Jayweiii/Clockor/renders/base-controller_3d.jpg

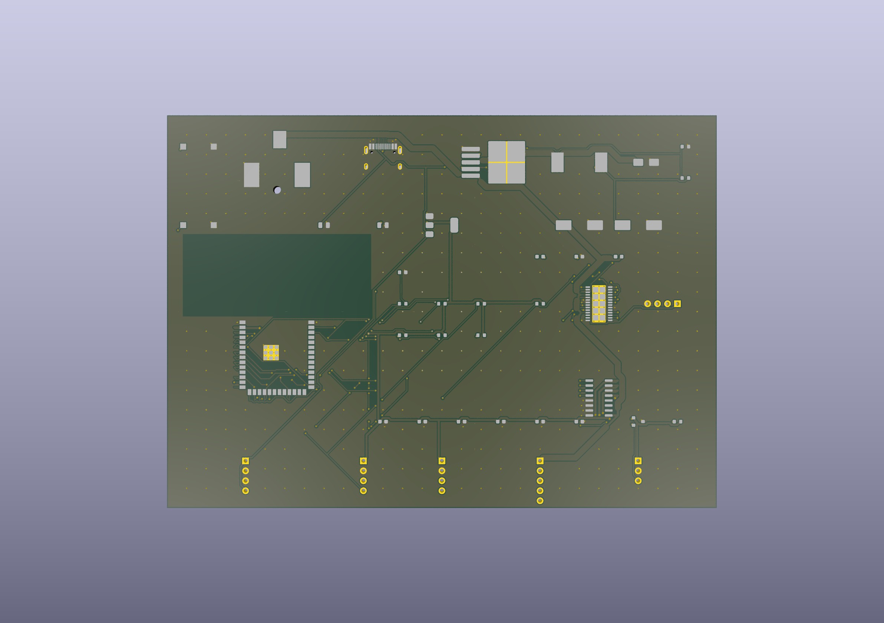
renders/base-controller_3d.jpg
