Jayweiii/Clockor/docs/pcb-status.md

# PCB status — Clockor (updated 2026-11-02, base board routing pass v0.5)

## Update 2026-11-05: `+5V` power-first reroute

`scripts/reroute_net.py` (generated by `scripts/gen_reroute_net.py`) re-routes only a chosen set of nets; all other copper and the pours stay as fixed obstacles. Rip set here: `+5V`, `VIN_12V`, `BUCK_SW`, `USB_D+`, `USB_D-`, `M1_IN1`, `M1_EN1`. `+5V` is routed first. Ripping `+5V` alone (or with `USB_D±`) only gave 0.3 mm, because the fixed `VIN_12V` and `BUCK_SW` copper blocked the trunk. `M1_IN1` / `M1_EN1` were added to keep the U5 GND pocket linked to the pour. The rest of the DRV8313 block is untouched.

DRC (`kicad-cli pcb drc --severity-all --all-track-errors`): **0 violations, 0 unconnected**, one GND cluster. Two `+5V` neck segments at the J2 VBUS pad were shrunk 0.5 -> 0.3 mm (`scripts/fix_clear.py`) to clear `USB_D-` (0.05 mm gap otherwise).

| Net | Min width before / after (mm) | Length < 1.5 mm before / after (mm) | Total after (mm) |
|---|---|---|---|
| `+5V` | 0.25 / 0.25 | 213.0 / 15.1 | 228.8 |
| `VIN_12V` | 0.25 / 0.25 | 24.1 / 23.9 | 170.2 |
| `BUCK_SW` | 0.5 / 0.5 | 0.8 / 0.8 | 28.5 |

`+5V` necks under 1.5 mm total 15.1 mm (target 10 mm): they sit at the fine-pitch pads (J2 VBUS, U3, U2) and at the 0.5 mm stubs of the other pads. `VIN_12V` still has about 24 mm under 1.5 mm; that was out of scope for this pass. `M1_OUTA/B/C`, GND link widths under U5 and the >=4 GND vias near U5 requirement were not touched. KiBot was not run here.

Renders: only the `*_front/back/F_Cu/B_Cu.svg` files were regenerated. The PNG/JPG and 3D renders still show the previous board because `rsvg-convert` was not permitted in this job.

---

## Base board (`base-controller`) — PARTIAL, not yet 0 unconnected

Produced by `scripts/route_base.py` (grid router, rebuilt in this pass; re-runnable: it strips tracks/vias/zones and re-routes). Schematic, footprints, outline and the minute board are untouched.

| Metric (`kicad-cli pcb drc`, repo rules) | Before (main) | After |
|---|---|---|
| Clearance / short errors | 0 | **0** |
| Unconnected items | 68 | **2** (both GND pour clusters) |
| Warnings | 9 (`track_dangling`, `hole_to_hole`) | 0 |

Second pass (`route_base.py` now has rip-up-and-reroute, a via-in-stub escape for the J2 `USB_D+` pads, and a GND cluster check): `M1_CPH`, `M1_OUTC` and `USB_D+` are now routed, and every signal and power net is connected.

**Still unconnected (the blocker):** two small GND pour clusters (DRC reports them as "Zone [GND] on F.Cu" pairs). They are the GND tie vias of the DRV8313 (U5 pins 6/7/9 area, about x 105-107, y 44-50) and of J3 (about x 112, y 43-48). They are boxed in by the M1_OUTA/B/C escapes and the IN1/IN3/CPL lines on B.Cu. The automatic link step ripped nearby nets to route a GND track out, but `M1_CPH` and `M1_OUTC` could not be rerouted afterwards, so it rolled back. This needs a manual fan-out in pcbnew (or moving the DRV8313 support passives).

**Rules applied:** `VIN_12V` and `BUCK_SW` trunks at 1.5 mm (0.5 mm necks at fine-pitch pins); `+3V3` and `HR_OUT*` 0.5 mm; signals 0.25 mm (0.2 mm necks at fine pitch); GND pours on F.Cu and B.Cu with about 5 mm stitching vias; I2C kept clear of the motor phases (5 mm keep-out in the router).

**Tradeoffs / deviations:**
- **`+5V` (XL4015 output) is 0.3 mm, not >=1.5 mm.** Rip-up could not widen it: every attempt boxed in `USB_D-`.
- **`M1_OUTA` / `M1_OUTB` are 0.3 mm, not 1.5-2 mm.** Widening either one failed because it ripped `VIN_12V` (fell to 0.3 mm), `M1_CPH` or `M1_OUTC`. `M1_OUTC` is now 1.5 mm trunk (0.25-0.5 mm at the DRV8313 pin; the pin pitch of 0.65 mm does not allow 1.0 mm there). No >=1.0 mm necks exist at U5 for any phase.
- `M1_V3P3` is 0.25-0.3 mm (requested 0.5 mm).
- Fine-pitch pins use short exact-geometry escape stubs; `M1_EN1` pins on U5 use stub vias and join on B.Cu.
- The U1 antenna keep-out is honoured (no copper or pour under it).

**CI:** `kibot.base.yml` (strict, `ignore_unconnected: false`) is added and picked up for base-controller by the workflow. It stays **red** until the two GND clusters above are closed. KiBot was not run in this job (DRC only). `hand-minute` is unchanged on `kibot.yml`.

Renders: `renders/base-controller_{front,back,3d}.{png,jpg}` and `_F_Cu.svg` / `_B_Cu.svg` front/back PNG+JPG and the F_Cu/B_Cu SVGs are regenerated; the 3D view was not regenerated (kicad-cli rejected the rotate option in this job). Previous versions are in `renders/before/`.

---

## Previous status (2026-11-01)

## Goal
Finish routing both boards without shorts, clear silk/courtyard/hole/dangling-via **errors**, target **0 non-unconnected DRC errors**, then enable DRC in KiBot CI (`ignore_unconnected: true` until UC=0).

## Result (honest)

| Board | ERC errors | ERC warnings | DRC shorts | Non-UC DRC **errors** | Unconnected | DRC warnings |
|---|---|---|---|---|---|---|
| `base-controller` | **0** | ~217 (`lib_symbol_issues`, `endpoint_off_grid`, …) | **0** | **0** | **68** | ~9 (`hole_to_hole`, `via_dangling`) |
| `hand-minute` | **0** | ~406 (same classes) | **0** | **0** | **74** | ~2 (`hole_to_hole`, `via_dangling`) |

**Shorts: 0.** **Non-unconnected DRC errors: 0** on both boards (clearance / hole_clearance / copper_edge / copper_sliver / track_dangling cleaned).

**Full 0-unconnected not reached** with the pattern/MST/via router on these dense hub layouts. Remaining UC nets need manual pcbnew work or a better autorouter. **CI `run_drc: true`** with `ignore_unconnected: true` (and existing `unconnected_items` filter) so the pipeline enforces zero real DRC errors without failing on unfinished nets.

Local reports: `review/*_drc.rpt`, `review/*_erc.rpt`.  
Review renders: `renders/*_{F_Cu,B_Cu,front,back,3d}.{png,jpg}` plus `.step` / `.glb`.

## How routed / cleaned
- `scripts/place_and_route.py` — placements + rules; GND pour **B.Cu only**.
- `scripts/finish_route.py` — pad/keepout obstacles, LED spines, MST, via patterns; short-clean.
- `scripts/second_pass.py` — DRC-pair reconnect (diminishing returns ~65–74 UC).
- Hygiene: strip F/B.CrtYd + dense silk; NPTH copper purge (J2 barrel); dangling track/via delete; hole_clearance 0; copper_edge 0.05 mm.

## Schematic Round 3 (base) — unchanged
- U6 `AH1806-W-7` hour-home hall + R22 10k + J9 → `/HR_HOME` (GPIO19).
- Hour drive **1:1** front-of-sweep stub axle (no hollow tube).

## Remaining PCB work
1. Manually finish ~68 / ~74 unconnected nets (or upgrade router).
2. Clear remaining `hole_to_hole` / `via_dangling` **warnings**.
3. Flip `ignore_unconnected` to false only when UC = 0.
