Jayweiii/Clockor/renders/base-controller_back.jpg

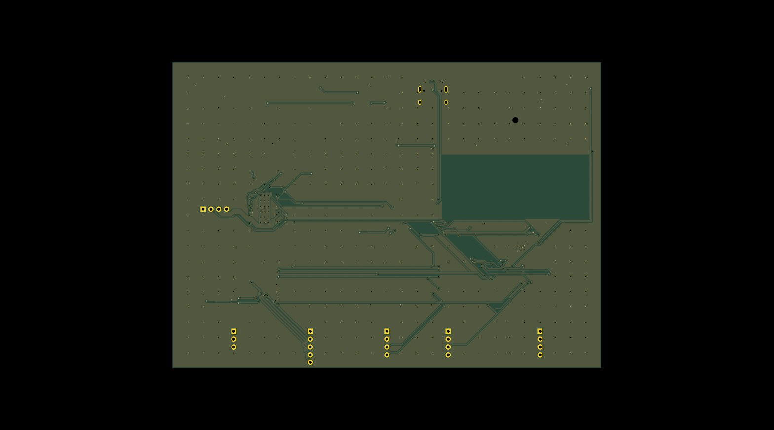
renders/base-controller_back.jpg
