Jayweiii/Clockor/renders/base-controller_back.png

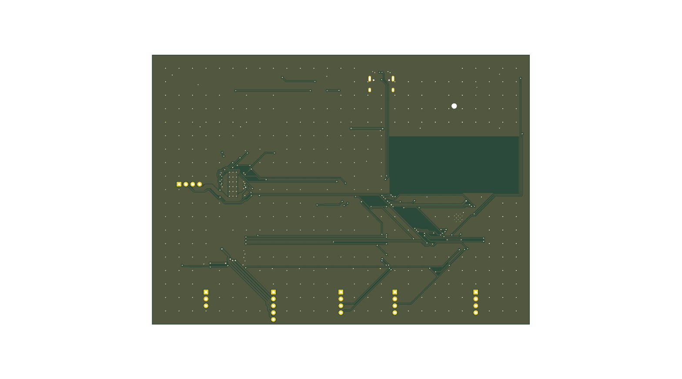
renders/base-controller_back.png
