Jayweiii/Clockor/renders/base-controller_front.jpg

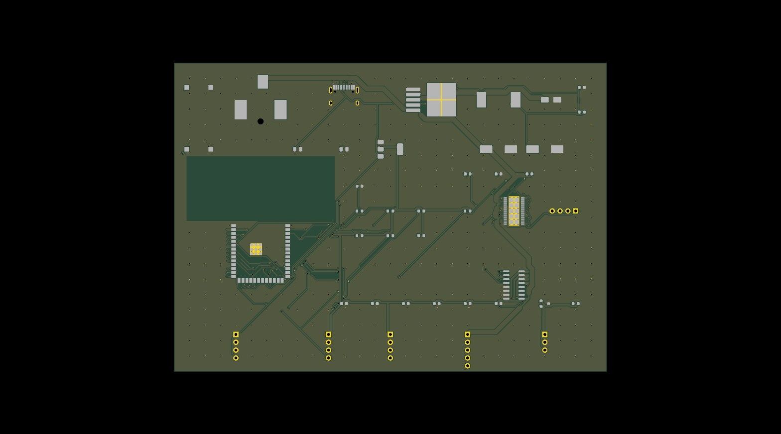
renders/base-controller_front.jpg
