Jayweiii/Clockor/renders/base-controller_front.png

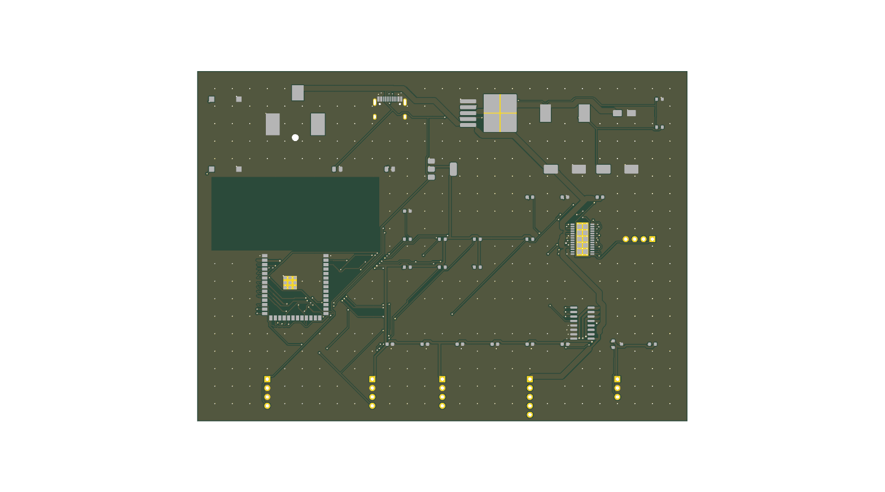
renders/base-controller_front.png
