Jayweiii/Clockor/renders/before/base-controller_3d.png

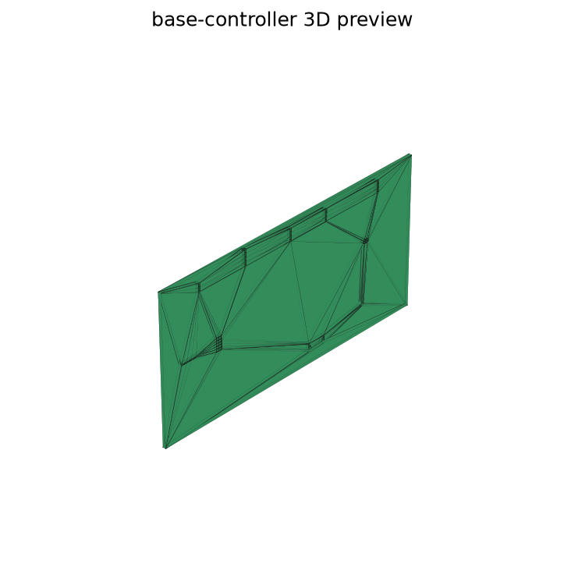
renders/before/base-controller_3d.png
