Jayweiii/Clockor/renders/before/base-controller_B_Cu.png

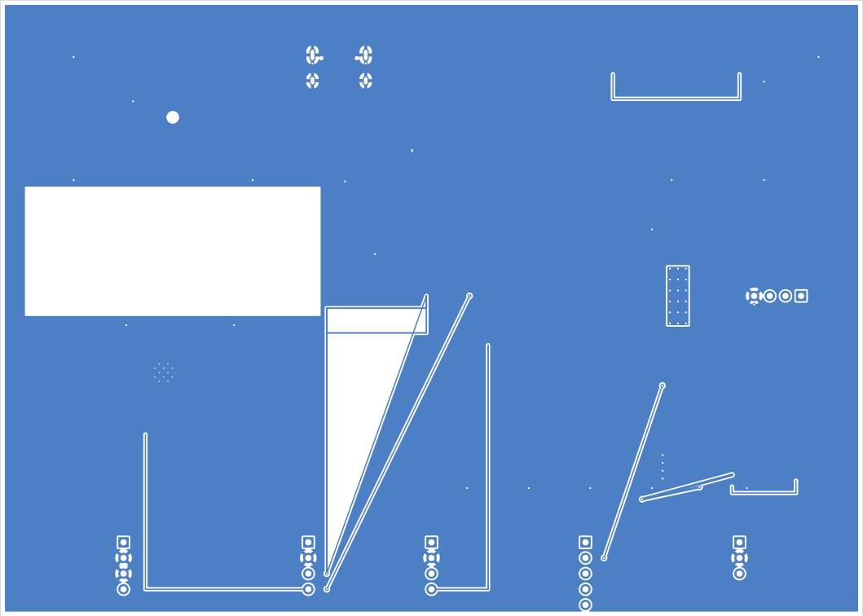
renders/before/base-controller_B_Cu.png
