Jayweiii/Clockor/renders/before/base-controller_F_Cu.png

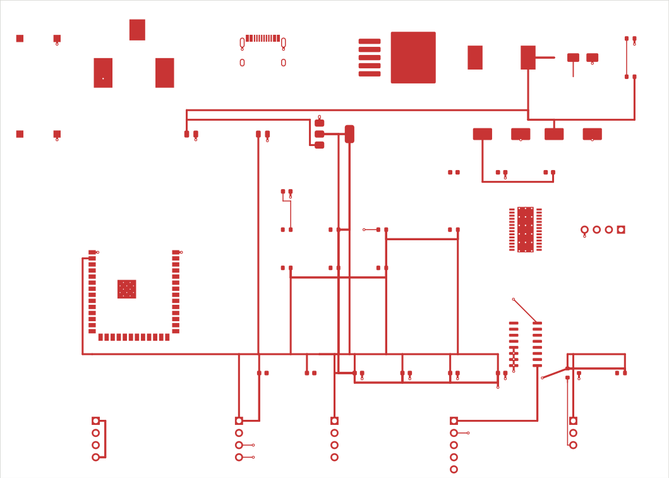
renders/before/base-controller_F_Cu.png
