Jayweiii/Clockor/renders/hand-minute_3d.jpg

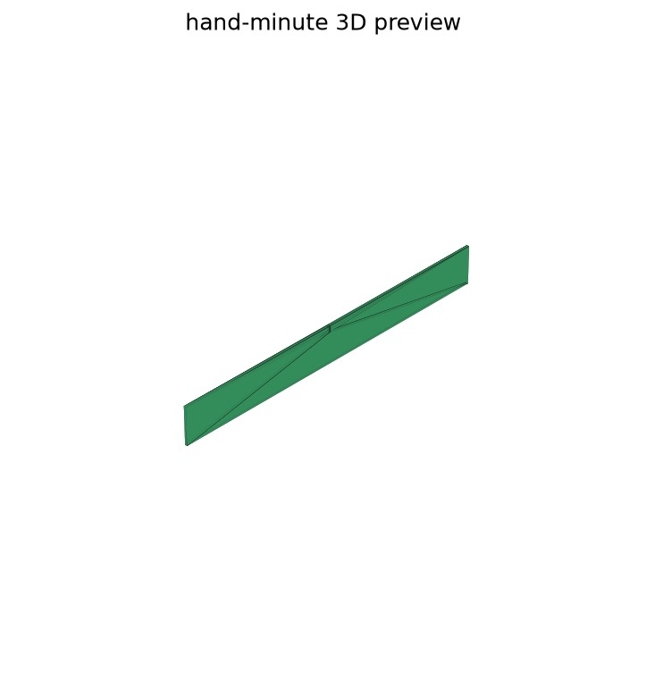
renders/hand-minute_3d.jpg
