Jayweiii/Clockor/renders/hand-minute_B_Cu.jpg

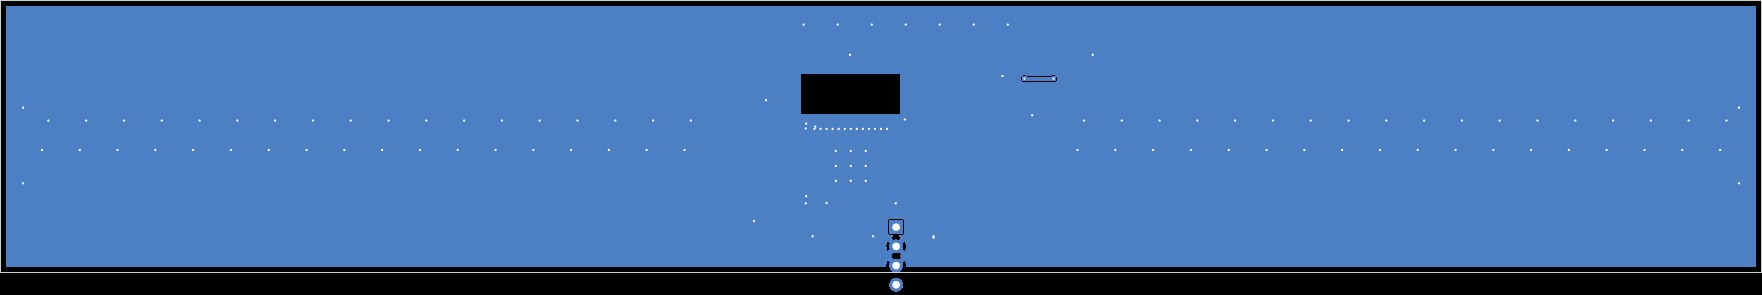
renders/hand-minute_B_Cu.jpg
