Jayweiii/Clockor/renders/hand-minute_B_Cu.png

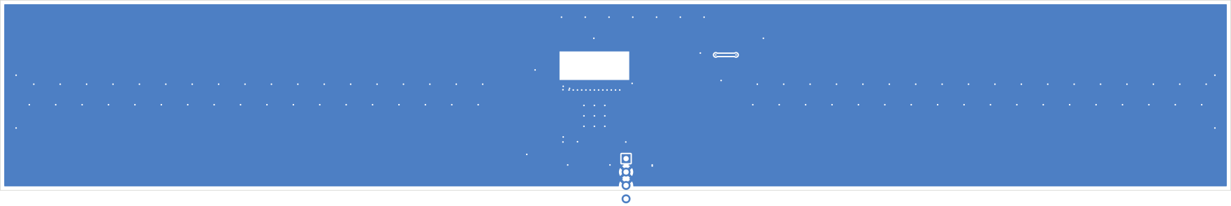
renders/hand-minute_B_Cu.png
