Jayweiii/Clockor/renders/hand-minute_F_Cu.jpg

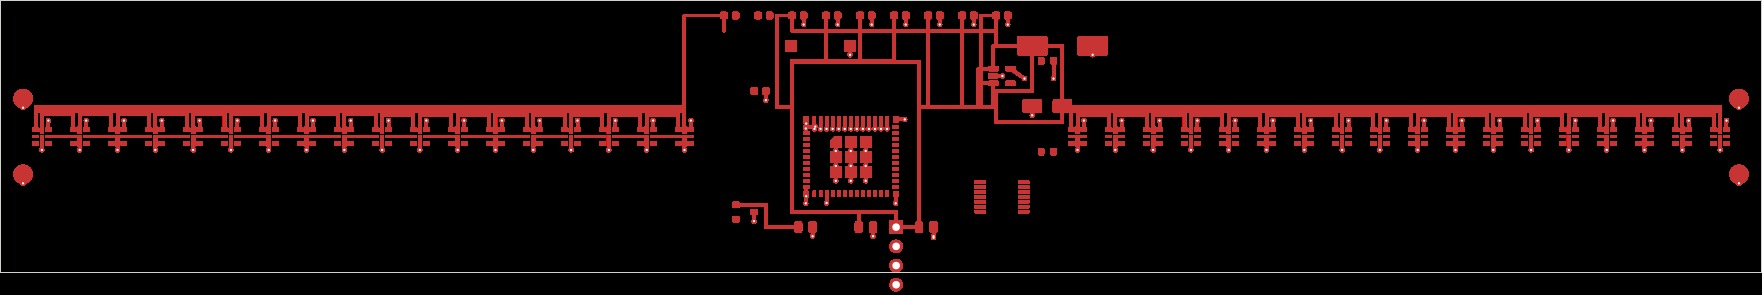
renders/hand-minute_F_Cu.jpg
