Jayweiii/Clockor/renders/hand-minute_F_Cu.png

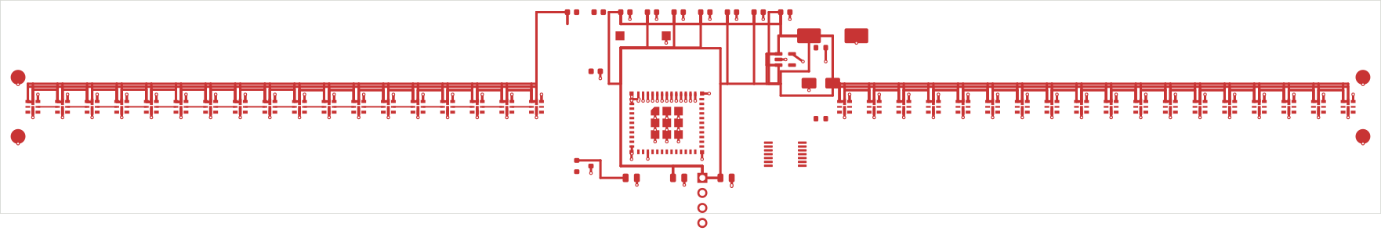
renders/hand-minute_F_Cu.png
