Jayweiii/Clockor/bom/master_bom_aggregated.csv

Value | Footprint | LCSC | Qty | Refs
100nF | Capacitor_SMD:C_0603_1608Metric |  | 17 | base-controller:C10;base-controller:C11;base-controller:C12;base-controller:C13;base-controller:C14;base-controller:C15;base-controller:C21;hand-minute:C1;hand-minute:Cd1;hand-minute:Cd2;hand-minute:Cd3;hand-minute:Cd4;hand-minute:Cd5;hand-minute:Cd6;hand-minute:Cd7;hand-minute:Cd8;hand-minute:Cd9
10k | Resistor_SMD:R_0603_1608Metric |  | 4 | base-controller:R20;base-controller:R21;hand-minute:R1;hand-minute:R2
10nF | Capacitor_SMD:C_0603_1608Metric |  | 1 | base-controller:C20
10uF | Capacitor_SMD:C_0805_2012Metric |  | 2 | base-controller:C4;hand-minute:C4
1k | Resistor_SMD:R_0603_1608Metric |  | 2 | base-controller:R1;base-controller:R4
22uF | Capacitor_SMD:C_0805_2012Metric |  | 3 | base-controller:C3;hand-minute:C2;hand-minute:C3
3.00k | Resistor_SMD:R_0603_1608Metric |  | 1 | base-controller:R5
4.7k | Resistor_SMD:R_0603_1608Metric |  | 4 | base-controller:R2;base-controller:R3;base-controller:R6;base-controller:R7
470nF | Capacitor_SMD:C_0603_1608Metric |  | 1 | base-controller:C22
470uF | Capacitor_SMD:CP_Elec_10x10 |  | 3 | base-controller:C1;base-controller:C2;hand-minute:C5
47uH | Inductor_SMD:L_TaiTech_TMPC1265_13.5x12.5mm |  | 1 | base-controller:L1
AH1806-W-7 | Package_TO_SOT_SMD:SC-59 | C126663 | 1 | hand-minute:U4
AMS1117-3.3 | Package_TO_SOT_SMD:SOT-223-3_TabPin2 | C6186 | 1 | base-controller:U3
APA102-2020 | LED_SMD:LED-APA102-2020 | C22439302 | 36 | hand-minute:D1;hand-minute:D2;hand-minute:D3;hand-minute:D4;hand-minute:D5;hand-minute:D6;hand-minute:D7;hand-minute:D8;hand-minute:D9;hand-minute:D10;hand-minute:D11;hand-minute:D12;hand-minute:D13;hand-minute:D14;hand-minute:D15;hand-minute:D16;hand-minute:D17;hand-minute:D18;hand-minute:D19;hand-minute:D20;hand-minute:D21;hand-minute:D22;hand-minute:D23;hand-minute:D24;hand-minute:D25;hand-minute:D26;hand-minute:D27;hand-minute:D28;hand-minute:D29;hand-minute:D30;hand-minute:D31;hand-minute:D32;hand-minute:D33;hand-minute:D34;hand-minute:D35;hand-minute:D36
BAL_PAD | TestPoint:TestPoint_Pad_D2.5mm |  | 4 | hand-minute:TP1;hand-minute:TP2;hand-minute:TP3;hand-minute:TP4
BOOT | Button_Switch_SMD:SW_SPST_CK_RS282G05A3 |  | 2 | base-controller:SW1;hand-minute:SW1
Conn_01x04 | Connector_PinHeader_2.54mm:PinHeader_1x04_P2.54mm_Vertical |  | 4 | base-controller:J3;base-controller:J5;base-controller:J6;base-controller:J7
Conn_01x05 | Connector_PinHeader_2.54mm:PinHeader_1x05_P2.54mm_Vertical |  | 1 | base-controller:J8
DC005-2.5 | Connector_BarrelJack:BarrelJack_CUI_PJ-036AH-SMT_Horizontal |  | 1 | base-controller:J1
DRV8313PWPR | Package_SO:HTSSOP-28-1EP_4.4x9.7mm_P0.65mm_EP3.4x9.5mm_ThermalVias | C92482 | 1 | base-controller:U5
ESP32-C3-MINI-1-N4 | Espressif:ESP32-C3-MINI-1 | C2934560 | 1 | hand-minute:U1
ESP32-S3-WROOM-1-N16R8 | RF_Module:ESP32-S3-WROOM-1 | C2913202 | 1 | base-controller:U1
LED_R | LED_SMD:LED_0603_1608Metric |  | 1 | base-controller:D2
ME6211C33M5G-N | Package_TO_SOT_SMD:SOT-23-5 | C235316 | 1 | hand-minute:U2
MODE | Button_Switch_SMD:SW_SPST_CK_RS282G05A3 |  | 1 | base-controller:SW2
SLIP_5V | Connector_PinHeader_2.54mm:PinHeader_1x04_P2.54mm_Vertical |  | 1 | hand-minute:J1
SMAJ5.0A | Diode_SMD:D_SMA | C83329 | 1 | hand-minute:D40
SN74AHCT125PWR | Package_SO:TSSOP-14_4.4x5mm_P0.65mm | C5947 | 1 | hand-minute:U3
SS54 | Diode_SMD:D_SMA | C8678 | 1 | base-controller:D1
TYPE-C-31-M-12 | Connector_USB:USB_C_Receptacle_HRO_TYPE-C-31-M-12 |  | 1 | base-controller:J2
ULN2003ADR | Package_SO:SOIC-16_3.9x9.9mm_P1.27mm | C7512 | 1 | base-controller:U4
XL4015E1 | Package_TO_SOT_SMD:TO-263-5_TabPin3 | C51661 | 1 | base-controller:U2
Furitek KOMODO 2204 1400KV | Minute BLDC 12S14P | 1 | mech | https://furitek.com/products/furitek-2204-outrunner-1400kv-motor
Mercotac 205 | Slip ring 2x4A 2000RPM | 1 | mech | https://www.mercotac.com/html/205.html
28BYJ-48 5V | Hour stepper off-axis | 1 | mech | common
Clear acrylic dial | Diffuser/face >=5mm gap | 1 | mech | local
