Jayweiii/Clockor/cad/pov_clock_assembly.step

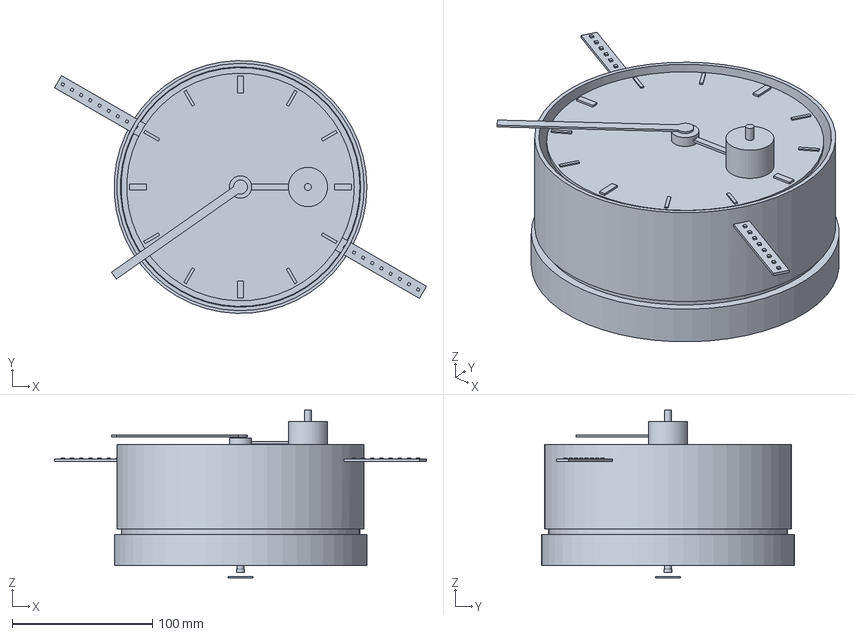
[picture p14: CAD file, 2026-11-01]
cad/pov_clock_assembly.step
264.8 x 179.9 x 119.5 mm
