Jayweiii/Clockor/cad/pov_clock_pov_mode.stl

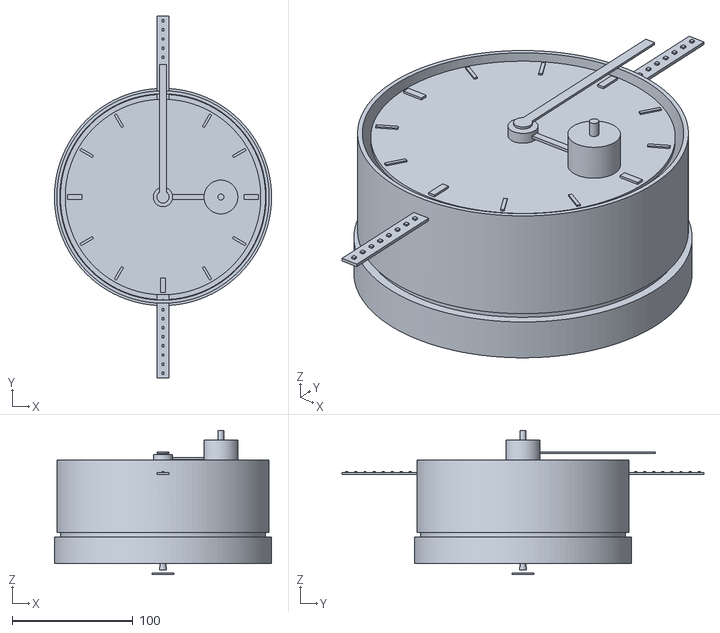
[picture p15: CAD file, 2026-11-01]
cad/pov_clock_pov_mode.stl
180.0 x 300.0 x 119.5
