Jayweiii/Clockor/renders/base-controller.step

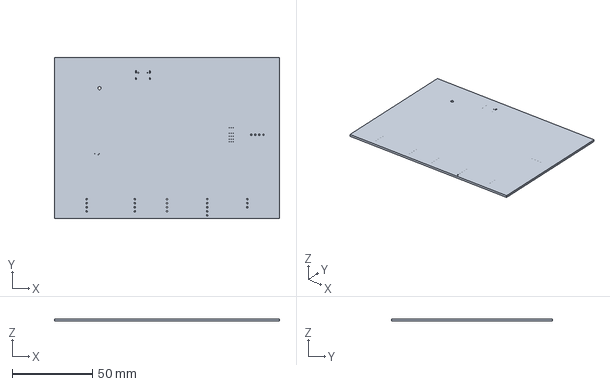
[picture p16: CAD file, 2026-11-01]
renders/base-controller.step
140.0 x 100.0 x 1.51 mm
