Jayweiii/Clockor/renders/hand-minute.step

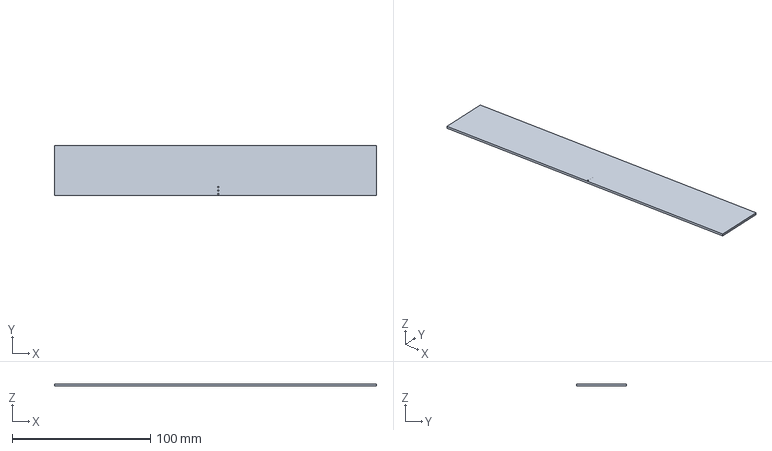
[picture p17: CAD file, 2026-11-01]
renders/hand-minute.step
233.0 x 36.0 x 1.51 mm
