Jayweiii/Clockor/cad/pov_clock_section.stl

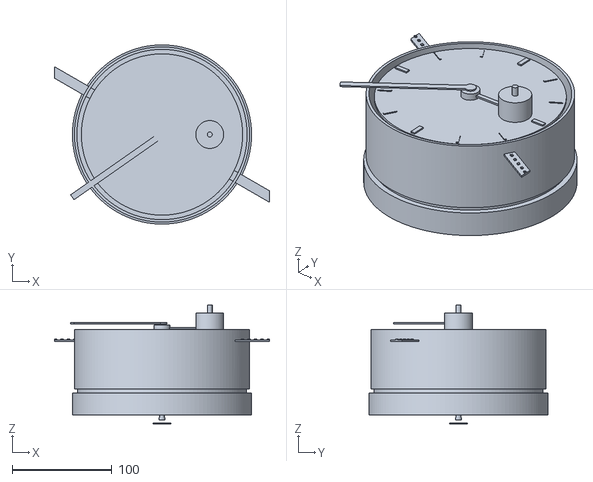
[picture p18: CAD file, 2026-11-01]
cad/pov_clock_section.stl
216.0 x 179.9 x 119.5
