Jayweiii/Clockor/cad/pov_clock_exploded.stl

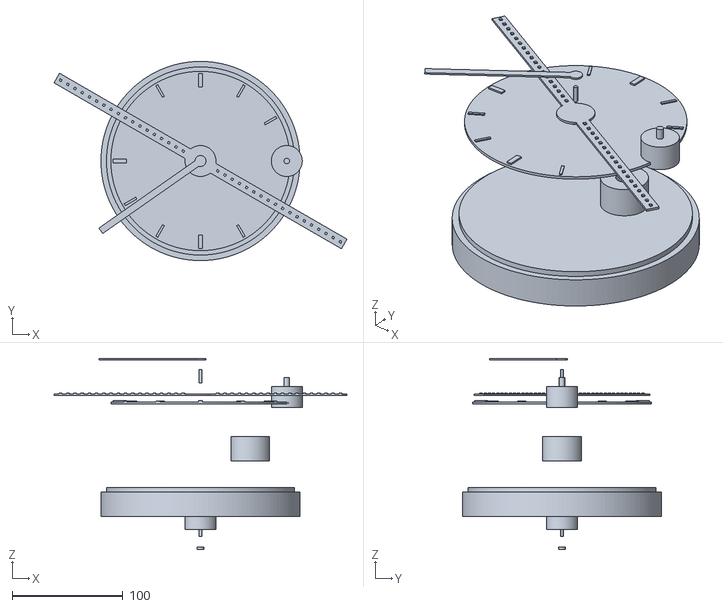
[picture p19: CAD file, 2026-11-01]
cad/pov_clock_exploded.stl
264.8 x 179.9 x 172.7
