Jayweiii/Clockor/(list of files, cad)

Other CAD files:
cad/pov_clock_clock_mode.stl
cad/pov_clock_assembly.stl
