Jayweiii/Clockor/review/hand-minute_schematic.pdf

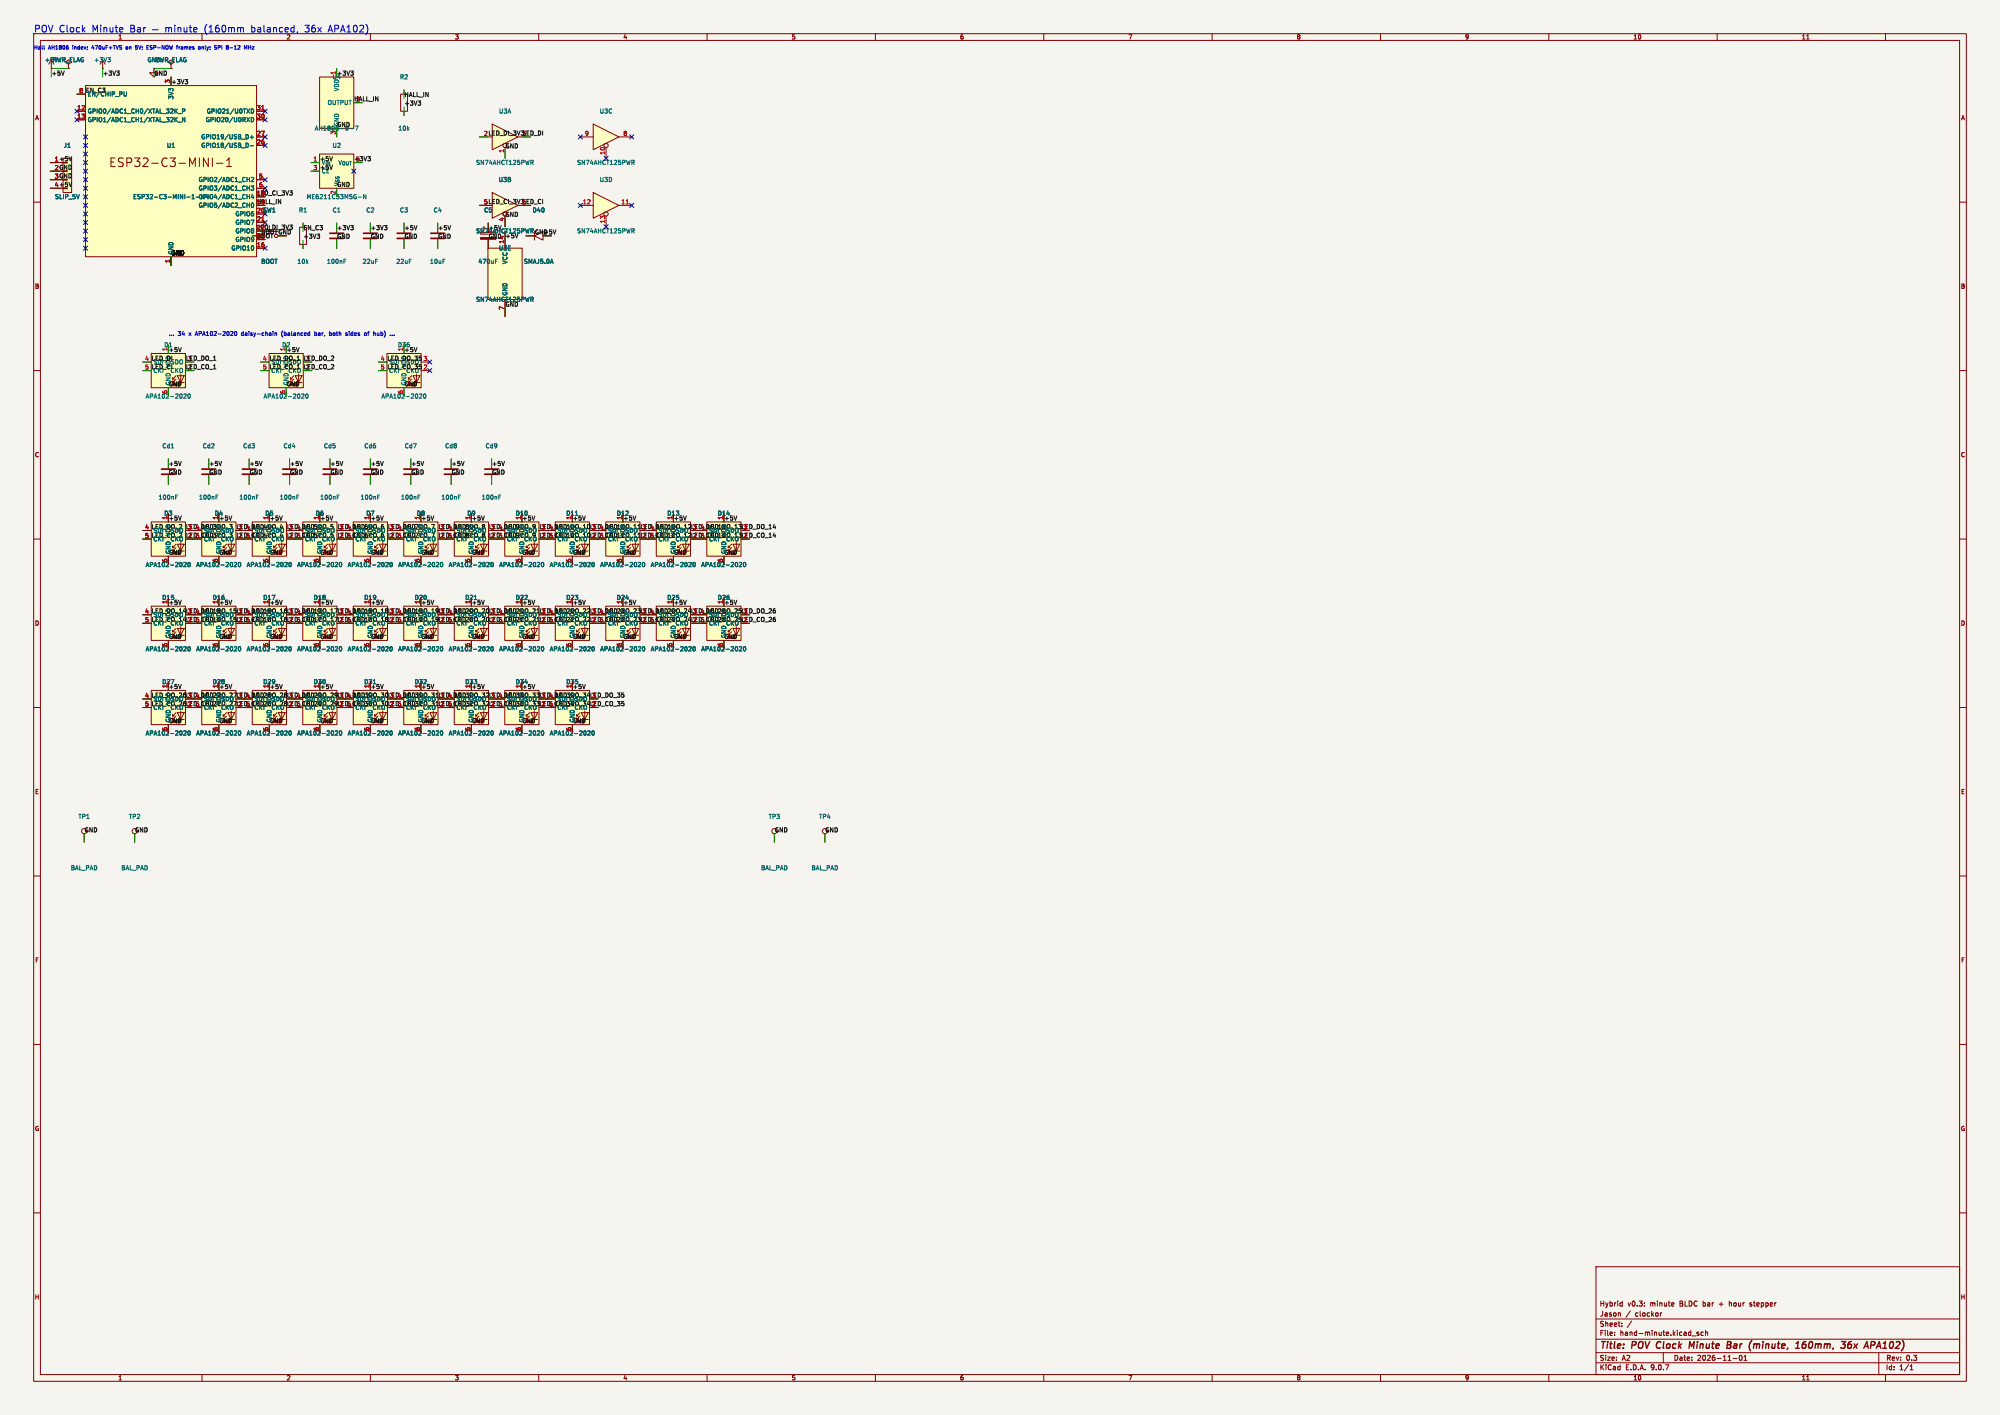
[picture p20: page 1]

6 SDO 3 CKO 2 D3 APA102-2020 SDI 4 CKI 5 VDD

6 SDO 3 CKO 2 D4 APA102-2020 SDI 4 CKI 5 VDD
LED_DO_16 +5V

6 SDO 3 CKO 2 D6 APA102-2020 SDI 4 CKI 5 VDD

6 SDO 3 CKO 2 D5 APA102-2020 SDI 4 CKI 5 VDD

6 SDO 3 CKO 2 D7 APA102-2020 SDI 4 CKI 5 VDD
LED_DO_6 +5V

6 SDO 3 CKO 2 D8 APA102-2020 SDI 4 CKI 5 VDD

6 SDO 3 CKO 2 D9 APA102-2020 SDI 4 CKI 5 VDD

6 SDO 3 CKO 2 D10 APA102-2020 SDI 4 CKI 5 VDD

6 SDO 3 CKO 2 D11 APA102-2020 SDI 4 CKI 5 VDD

6 SDO 3 CKO 2 D12 APA102-2020 SDI 4 CKI 5 VDD

6 SDO 3 CKO 2 D13 APA102-2020 SDI 4 CKI 5 VDD

6 SDO 3 CKO 2 D17 APA102-2020 SDI 4 CKI 5 VDD

6 SDO 3 CKO 2 D16 APA102-2020 SDI 4 CKI 5 VDD

6 SDO 3 CKO 2 D20 APA102-2020 SDI 4 CKI 5 VDD

6 SDO 3 CKO 2 D21 APA102-2020 SDI 4 CKI 5 VDD

6 SDO 3 CKO 2 D26 APA102-2020 SDI 4 CKI 5 VDD

6 SDO 3 CKO 2 D15 APA102-2020 SDI 4 CKI 5 VDD

6 SDO 3 CKO 2 D18 APA102-2020 SDI 4 CKI 5 VDD

6 SDO 3 CKO 2 D19 APA102-2020 SDI 4 CKI 5 VDD

6 SDO 3 CKO 2 D22 APA102-2020 SDI 4 CKI 5 VDD
LED_DO_21 +5V

6 SDO 3 CKO 2 D25 APA102-2020 SDI 4 CKI 5 VDD

6 SDO 3 CKO 2 D24 APA102-2020 SDI 4 CKI 5 VDD

6 SDO 3 CKO 2 D23 APA102-2020 SDI 4 CKI 5 VDD

6 SDO 3 CKO 2 D29 APA102-2020 SDI 4 CKI 5 VDD

6 SDO 3 CKO 2 D35 APA102-2020 SDI 4 CKI 5 VDD
LED_CO_22

6 SDO 3 CKO 2 D28 APA102-2020 SDI 4 CKI 5 VDD

6 SDO 3 CKO 2 D30 APA102-2020 SDI 4 CKI 5 VDD

6 SDO 3 CKO 2 D31 APA102-2020 SDI 4 CKI 5 VDD

6 SDO 3 CKO 2 D33 APA102-2020 SDI 4 CKI 5 VDD
LED_DO_32 GND
LED_CO_32

6 SDO 3 CKO 2 D34 APA102-2020 SDI 4 CKI 5 VDD
LED_DO_33 GND
LED_CO_33
