Jayweiii/Clockor/hardware/base-controller/base-controller.kicad_pcb

## KiCad design hardware/base-controller/base-controller.kicad_pcb (2026-11-05)

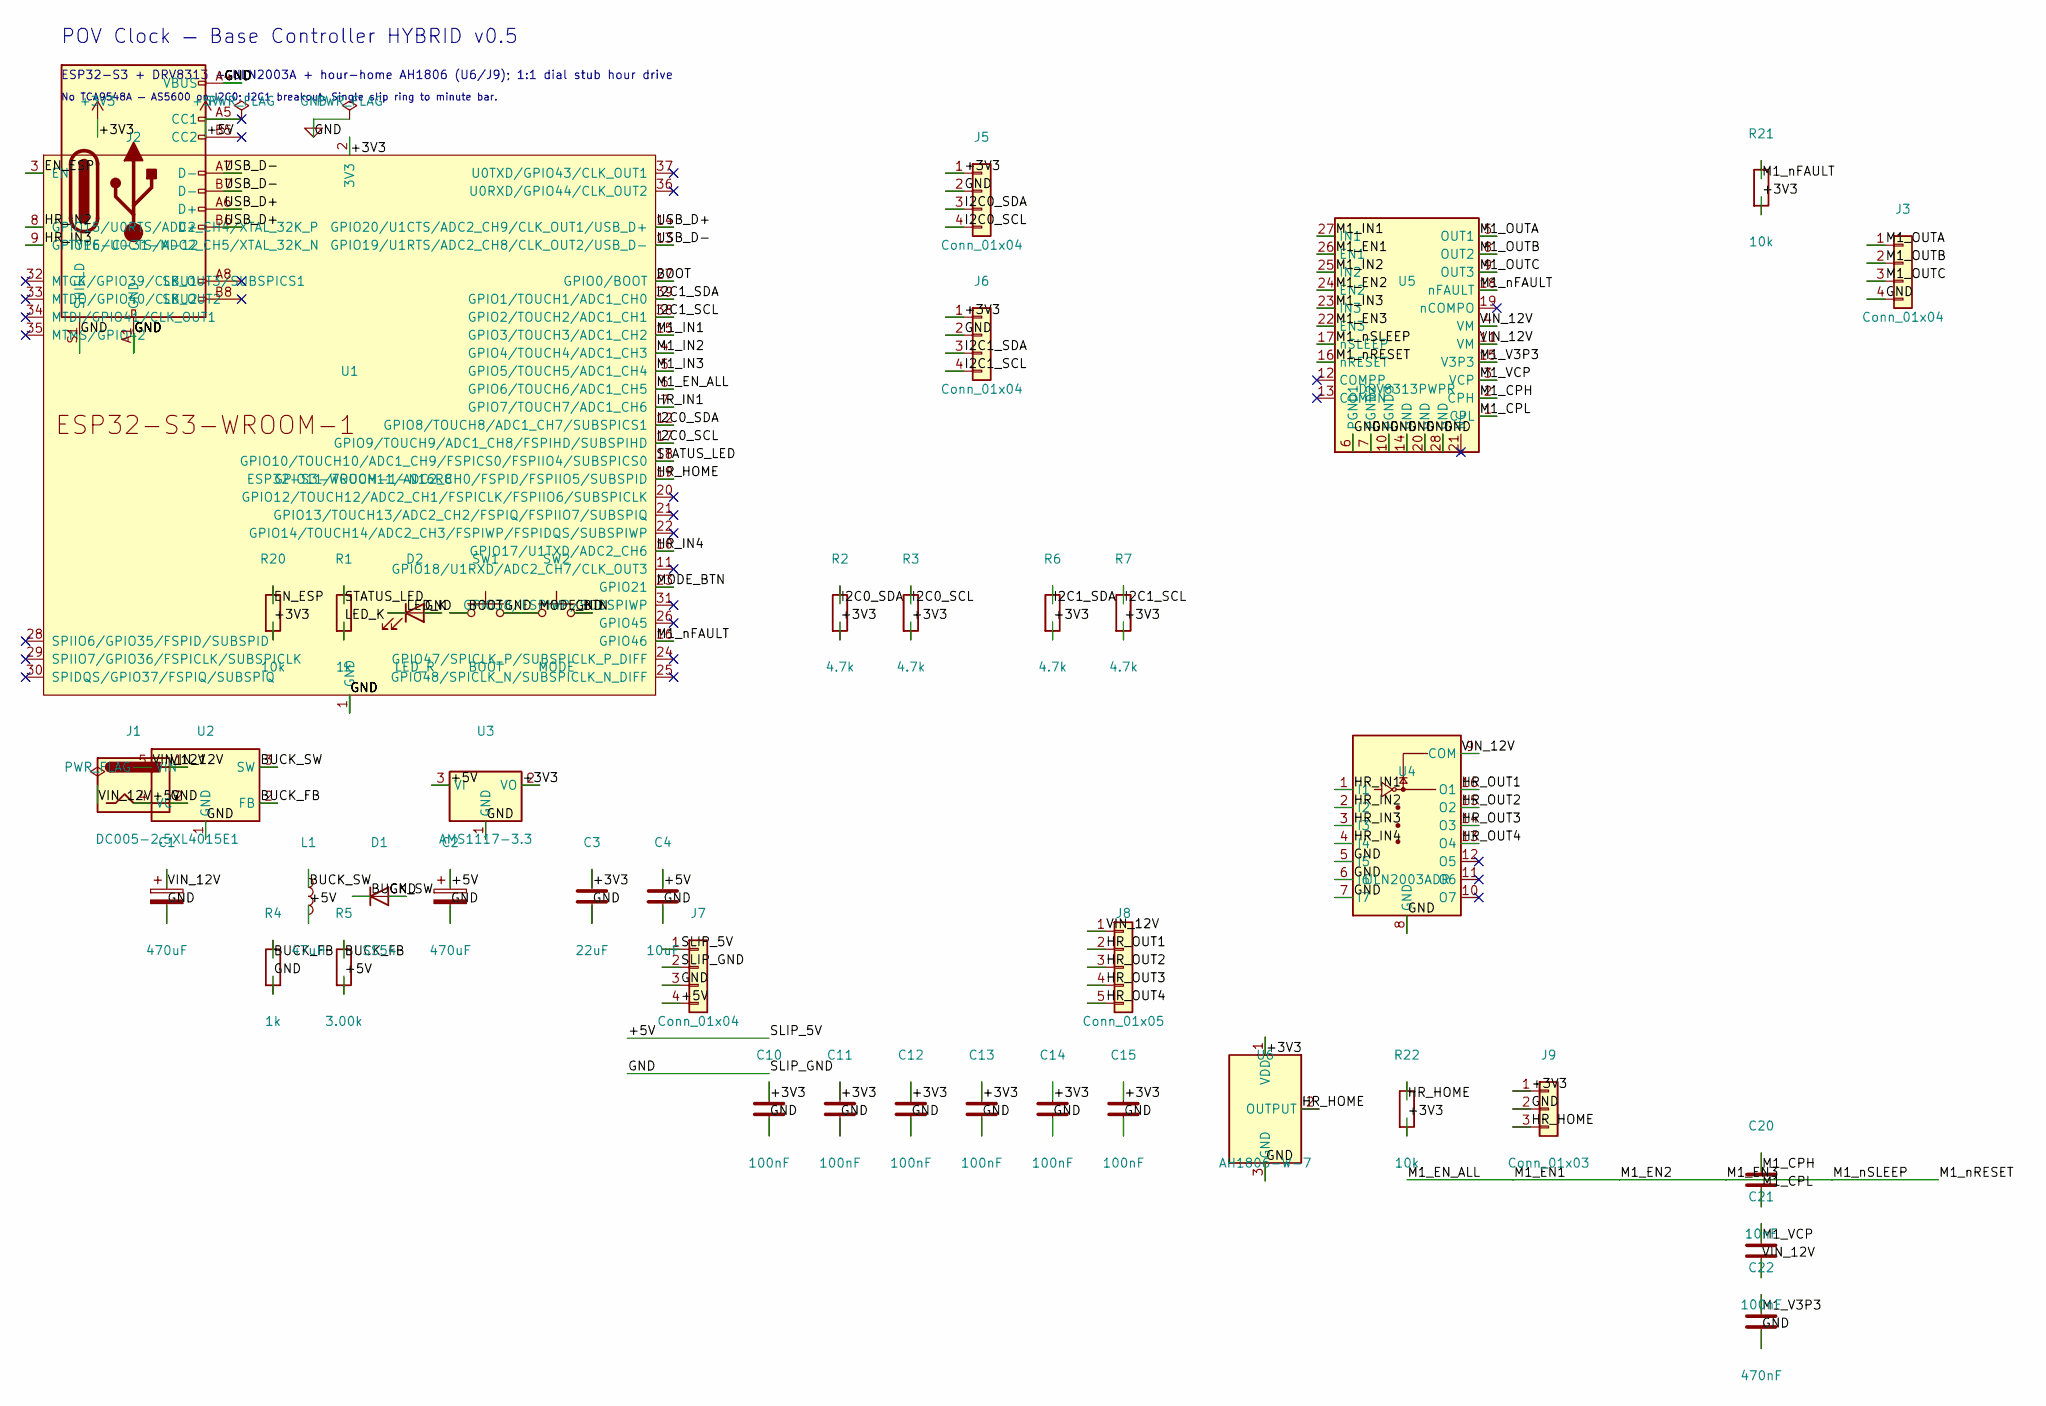
[picture p22: schematic base-controller.kicad_sch, POV Clock — Base Controller (Hybrid)]

Parts:
C1, C2: 470uF; CP_Elec_10x10
C3: 22uF; C_0805_2012Metric
C4: 10uF; C_0805_2012Metric
C10, C11, C12, C13, C14, C15, C21: 100nF; C_0603_1608Metric
C20: 10nF; C_0603_1608Metric
C22: 470nF; C_0603_1608Metric
D1: SS54; D_SMA
D2: LED_R; LED_0603_1608Metric
J1: DC005-2.5; BarrelJack_CUI_PJ-036AH-SMT_Horizontal
J2: TYPE-C-31-M-12; USB_C_Receptacle_HRO_TYPE-C-31-M-12
J3, J5, J6, J7: Conn_01x04; PinHeader_1x04_P2.54mm_Vertical
J8: Conn_01x05; PinHeader_1x05_P2.54mm_Vertical
J9: Conn_01x03; PinHeader_1x03_P2.54mm_Vertical
L1: 47uH; L_TaiTech_TMPC1265_13.5x12.5mm
R1, R4: 1k; R_0603_1608Metric
R2, R3, R6, R7: 4.7k; R_0603_1608Metric
R5: 3.00k; R_0603_1608Metric
R20, R21, R22: 10k; R_0603_1608Metric
SW1: BOOT; SW_SPST_CK_RS282G05A3
SW2: MODE; SW_SPST_CK_RS282G05A3
U1: ESP32-S3-WROOM-1-N16R8; ESP32-S3-WROOM-1
U2: XL4015E1; TO-263-5_TabPin3
U3: AMS1117-3.3; SOT-223-3_TabPin2
U4: ULN2003ADR; SOIC-16_3.9x9.9mm_P1.27mm
U5: DRV8313PWPR; HTSSOP-28-1EP_4.4x9.7mm_P0.65mm_EP3.4x9.5mm_ThermalVias
U6: AH1806-W-7; SC-59

Connections:
+3V3: C3.1, C10.1, C11.1, C12.1, C13.1, C14.1, C15.1, J5.1, J6.1, J9.1, R2.2, R3.2, R6.2, R7.2, R20.2, R21.2, R22.2, U1.2 (3V3), U3.2 (VO), U6.1 (VDD)
+5V: C2.1, C4.1, J2.A5 (CC1), J7.1, J7.4, L1.2, R5.2, U2.4 (VC), U3.3 (VI)
/BOOT: SW1.1, U1.27 (GPIO0/BOOT)
/BUCK_FB: R4.1, R5.1, U2.2 (FB)
/BUCK_SW: D1.1 (K), L1.1, U2.3 (SW)
/EN_ESP: R20.1, U1.3 (EN)
/HR_HOME: J9.3, R22.1, U1.19 (GPIO11/TOUCH11/ADC2_CH0/FSPID/FSPIIO5/S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), U6.2 (OUTPUT)
/HR_IN1: U1.7 (GPIO7/TOUCH7/ADC1_CH6), U4.1 (I1)
/HR_IN2: U1.8 (GPIO15/U0RTS/ADC2_CH4/XTAL_32K_P), U4.2 (I2)
/HR_IN3: U1.9 (GPIO16/U0CTS/ADC2_CH5/XTAL_32K_N), U4.3 (I3)
/HR_IN4: U1.10 (GPIO17/U1TXD/ADC2_CH6), U4.4 (I4)
/HR_OUT1: J8.2, U4.16 (O1)
/HR_OUT2: J8.3, U4.15 (O2)
/HR_OUT3: J8.4, U4.14 (O3)
/HR_OUT4: J8.5, U4.13 (O4)
/I2C0_SCL: J5.4, R3.1, U1.17 (GPIO9/TOUCH9/ADC1_CH8/FSPIHD/SUBSPIHD)
/I2C0_SDA: J5.3, R2.1, U1.12 (GPIO8/TOUCH8/ADC1_CH7/SUBSPICS1)
/I2C1_SCL: J6.4, R7.1, U1.38 (GPIO2/TOUCH2/ADC1_CH1)
/I2C1_SDA: J6.3, R6.1, U1.39 (GPIO1/TOUCH1/ADC1_CH0)
/LED_K: D2.1 (K), R1.2
/M1_CPH: C20.1, U5.2 (CPH)
/M1_CPL: C20.2, U5.1 (CPL)
/M1_EN1: U1.6 (GPIO6/TOUCH6/ADC1_CH5), U5.16 (nRESET), U5.17 (nSLEEP), U5.22 (EN3), U5.24 (EN2), U5.26 (EN1)
/M1_IN1: U1.15 (GPIO3/TOUCH3/ADC1_CH2), U5.27 (IN1)
/M1_IN2: U1.4 (GPIO4/TOUCH4/ADC1_CH3), U5.25 (IN2)
/M1_IN3: U1.5 (GPIO5/TOUCH5/ADC1_CH4), U5.23 (IN3)
/M1_OUTA: J3.1, U5.5 (OUT1)
/M1_OUTB: J3.2, U5.8 (OUT2)
/M1_OUTC: J3.3, U5.9 (OUT3)
/M1_V3P3: C22.1, U5.15 (V3P3)
/M1_VCP: C21.1, U5.3 (VCP)
/M1_nFAULT: R21.1, U1.16 (GPIO46), U5.18 (nFAULT)
/MODE_BTN: SW2.1, U1.23 (GPIO21)
/STATUS_LED: R1.1, U1.18 (GPIO10/TOUCH10/ADC1_CH9/FSPICS0/FSPIIO4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)
/USB_D+: J2.A6 (D+), J2.B6 (D+), U1.14 (GPIO20/U1CTS/ADC2_CH9/CLK_OUT1/USB_D+)
/USB_D-: J2.A7 (D-), J2.B7 (D-), U1.13 (GPIO19/U1RTS/ADC2_CH8/CLK_OUT2/USB_D-)
/VIN_12V: C1.1, C21.2, J1.1, J8.1, U2.5 (VIN), U4.9 (COM), U5.4 (VM), U5.11 (VM)
GND: C1.2, C2.2, C3.2, C4.2, C10.2, C11.2, C12.2, C13.2, C14.2, C15.2, C22.2, D1.2 (A), D2.2 (A), J1.2, J2.A1 (GND), J2.A4 (VBUS), J2.A9 (VBUS), J2.A12 (GND), J2.B1 (GND), J2.B4 (VBUS), J2.B9 (VBUS), J2.B12 (GND), J2.S1 (SHIELD), J3.4, J5.2, J6.2, J7.2, J7.3, J9.2, R4.2, SW1.2, SW2.2, U1.1 (GND), U1.40 (GND), U1.41 (GND), U2.1 (GND), U3.1 (GND), U4.5 (I5), U4.6 (I6), U4.7 (I7), U4.8 (GND), U5.6 (PGND1), U5.7 (PGND2), U5.10 (PGND3), U5.14 (GND), U5.20 (GND), U5.28 (GND), U6.3 (GND)

Notes on the sheet:
POV Clock — Base Controller HYBRID v0.5
ESP32-S3 + DRV8313 + ULN2003A + hour-home AH1806 (U6/J9); 1:1 dial stub hour drive
No TCA9548A — AS5600 on I2C0; I2C1 breakout. Single slip ring to minute bar.

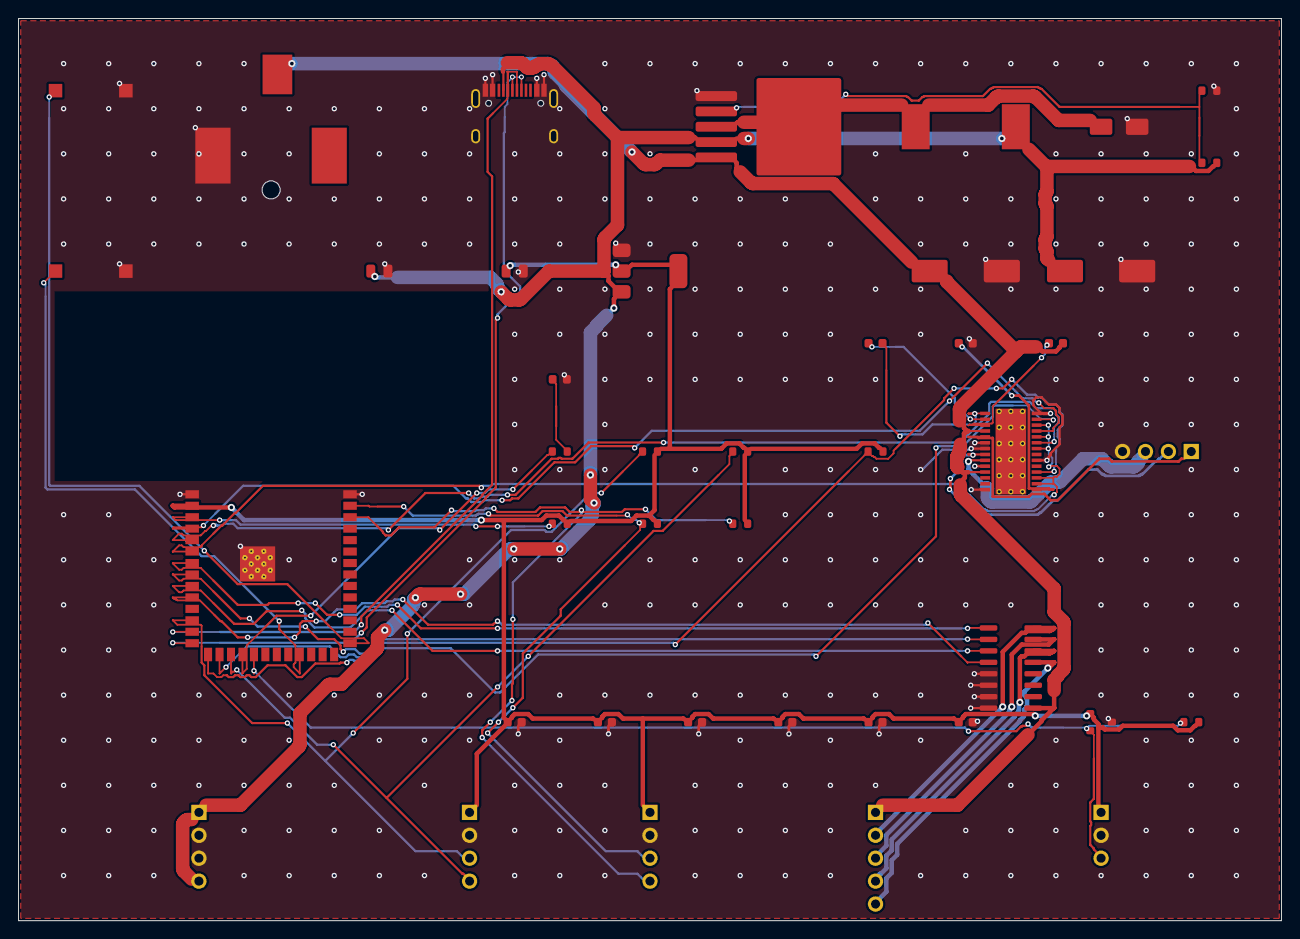
[picture p23: board base-controller.kicad_pcb from above]

Board: 2 copper layers, 140.0 x 100.0 mm, 42 parts (0 on the bottom side), 38 nets.
