Jayweiii/Clockor/hardware/hand-minute/hand-minute.kicad_pcb

## KiCad design hardware/hand-minute/hand-minute.kicad_pcb (2026-11-01)

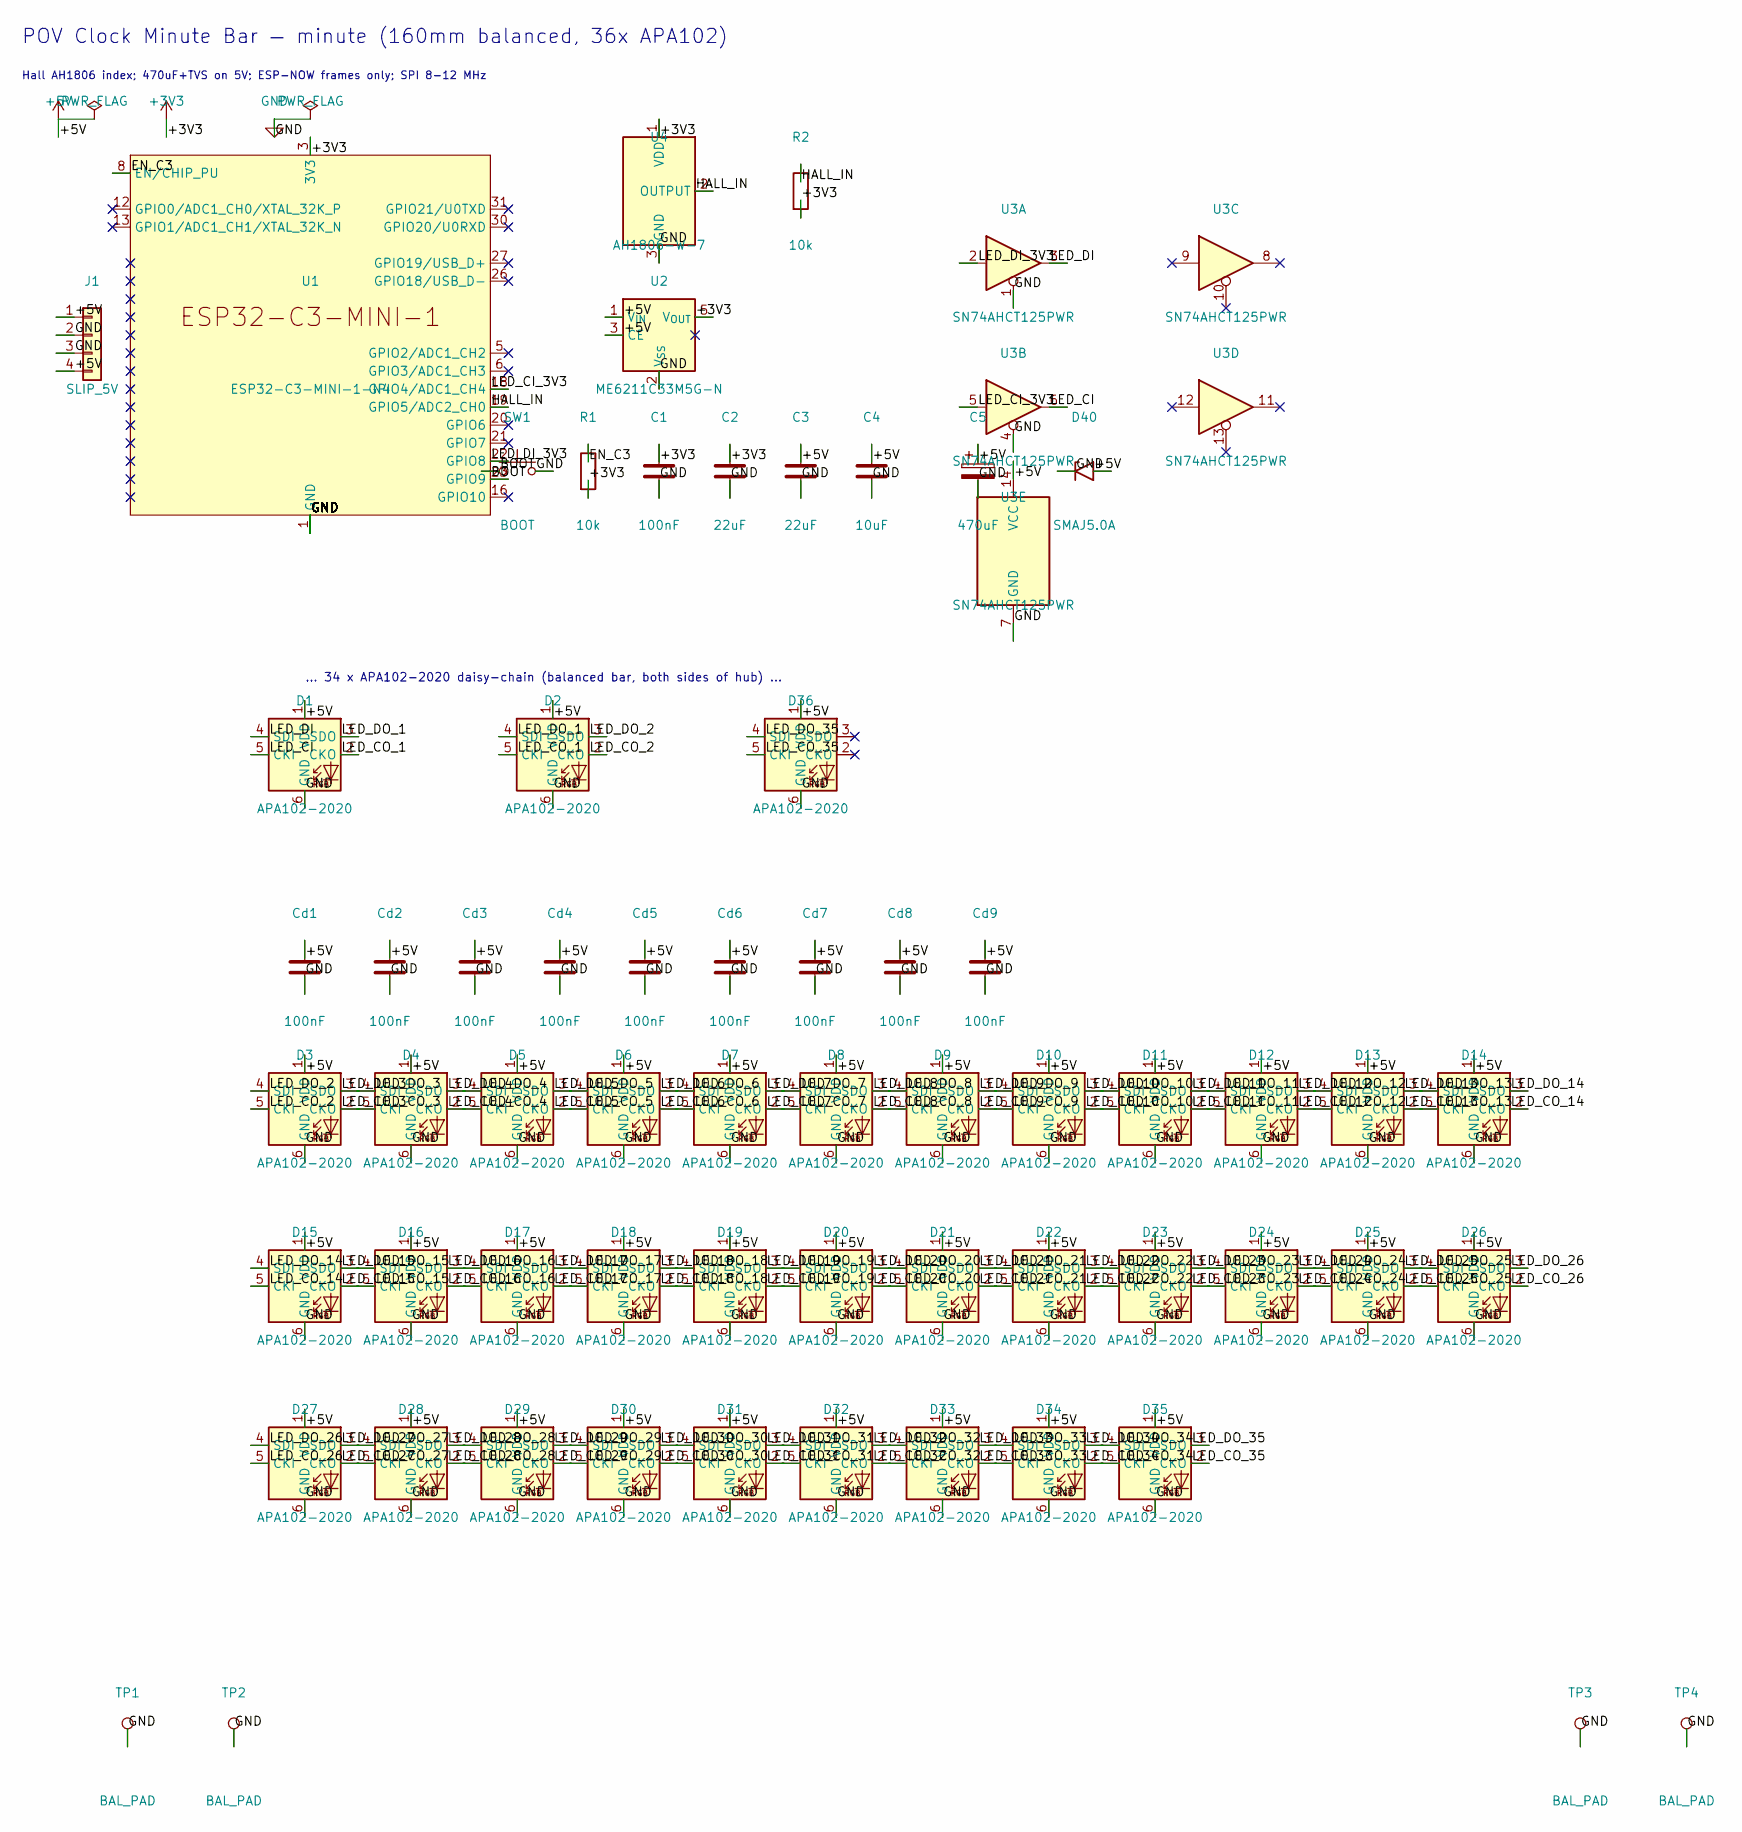
[picture p24: schematic hand-minute.kicad_sch, POV Clock Minute Bar (minute, 160mm, 36x APA102)]

Parts:
C1: 100nF; C_0603_1608Metric
C2, C3: 22uF; C_0805_2012Metric
C4: 10uF; C_0805_2012Metric
C5: 470uF; CP_Elec_10x10
Cd1, Cd2, Cd3, Cd4, Cd5, Cd6, Cd7, Cd8, Cd9: 100nF; C_0603_1608Metric
D1, D2, D3, D4, D5, D6, D7, D8, D9, D10, D11, D12, D13, D14, D15, D16, D17, D18, D19, D20, D21, D22, D23, D24, D25, D26, D27, D28, D29, D30, D31, D32, D33, D34, D35, D36: APA102-2020; LED-APA102-2020
D40: SMAJ5.0A; D_SMA
J1: SLIP_5V; PinHeader_1x04_P2.54mm_Vertical
R1, R2: 10k; R_0603_1608Metric
SW1: BOOT; SW_SPST_CK_RS282G05A3
TP1, TP2, TP3, TP4: BAL_PAD; TestPoint_Pad_D2.5mm
U1: ESP32-C3-MINI-1-N4; ESP32-C3-MINI-1
U2: ME6211C33M5G-N; SOT-23-5
U3: SN74AHCT125PWR; TSSOP-14_4.4x5mm_P0.65mm
U4: AH1806-W-7; SC-59

Connections:
+3V3: C1.1, C2.1, R1.2, R2.2, U1.3 (3V3), U2.5 (V_{OUT}), U4.1 (VDD)
+5V: C3.1, C4.1, C5.1, Cd1.1, Cd2.1, Cd3.1, Cd4.1, Cd5.1, Cd6.1, Cd7.1, Cd8.1, Cd9.1, D1.1 (VDD), D2.1 (VDD), D3.1 (VDD), D4.1 (VDD), D5.1 (VDD), D6.1 (VDD), D7.1 (VDD), D8.1 (VDD), D9.1 (VDD), D10.1 (VDD), D11.1 (VDD), D12.1 (VDD), D13.1 (VDD), D14.1 (VDD), D15.1 (VDD), D16.1 (VDD), D17.1 (VDD), D18.1 (VDD), D19.1 (VDD), D20.1 (VDD), D21.1 (VDD), D22.1 (VDD), D23.1 (VDD), D24.1 (VDD), D25.1 (VDD), D26.1 (VDD), D27.1 (VDD), D28.1 (VDD), D29.1 (VDD), D30.1 (VDD), D31.1 (VDD), D32.1 (VDD), D33.1 (VDD), D34.1 (VDD), D35.1 (VDD), D36.1 (VDD), D40.2 (A2), J1.1, J1.4, U2.1 (V_{IN}), U2.3 (CE), U3.14 (VCC)
/BOOT: SW1.1, U1.23 (GPIO9)
/EN_C3: R1.1, U1.8 (EN/CHIP_PU)
/HALL_IN: R2.1, U1.19 (GPIO5/ADC2_CH0), U4.2 (OUTPUT)
/LED_CI: D1.5 (CKI), U3.6
/LED_CI_3V3: U1.18 (GPIO4/ADC1_CH4), U3.5
/LED_CO_1: D1.2 (CKO), D2.5 (CKI)
/LED_CO_2: D2.2 (CKO), D3.5 (CKI)
/LED_CO_3: D3.2 (CKO), D4.5 (CKI)
/LED_CO_4: D4.2 (CKO), D5.5 (CKI)
/LED_CO_5: D5.2 (CKO), D6.5 (CKI)
/LED_CO_6: D6.2 (CKO), D7.5 (CKI)
/LED_CO_7: D7.2 (CKO), D8.5 (CKI)
/LED_CO_8: D8.2 (CKO), D9.5 (CKI)
/LED_CO_9: D9.2 (CKO), D10.5 (CKI)
/LED_CO_10: D10.2 (CKO), D11.5 (CKI)
/LED_CO_11: D11.2 (CKO), D12.5 (CKI)
/LED_CO_12: D12.2 (CKO), D13.5 (CKI)
/LED_CO_13: D13.2 (CKO), D14.5 (CKI)
/LED_CO_14: D14.2 (CKO), D15.5 (CKI)
/LED_CO_15: D15.2 (CKO), D16.5 (CKI)
/LED_CO_16: D16.2 (CKO), D17.5 (CKI)
/LED_CO_17: D17.2 (CKO), D18.5 (CKI)
/LED_CO_18: D18.2 (CKO), D19.5 (CKI)
/LED_CO_19: D19.2 (CKO), D20.5 (CKI)
/LED_CO_20: D20.2 (CKO), D21.5 (CKI)
/LED_CO_21: D21.2 (CKO), D22.5 (CKI)
/LED_CO_22: D22.2 (CKO), D23.5 (CKI)
/LED_CO_23: D23.2 (CKO), D24.5 (CKI)
/LED_CO_24: D24.2 (CKO), D25.5 (CKI)
/LED_CO_25: D25.2 (CKO), D26.5 (CKI)
/LED_CO_26: D26.2 (CKO), D27.5 (CKI)
/LED_CO_27: D27.2 (CKO), D28.5 (CKI)
/LED_CO_28: D28.2 (CKO), D29.5 (CKI)
/LED_CO_29: D29.2 (CKO), D30.5 (CKI)
/LED_CO_30: D30.2 (CKO), D31.5 (CKI)
/LED_CO_31: D31.2 (CKO), D32.5 (CKI)
/LED_CO_32: D32.2 (CKO), D33.5 (CKI)
/LED_CO_33: D33.2 (CKO), D34.5 (CKI)
/LED_CO_34: D34.2 (CKO), D35.5 (CKI)
/LED_CO_35: D35.2 (CKO), D36.5 (CKI)
/LED_DI: D1.4 (SDI), U3.3
/LED_DI_3V3: U1.22 (GPIO8), U3.2
/LED_DO_1: D1.3 (SDO), D2.4 (SDI)
/LED_DO_2: D2.3 (SDO), D3.4 (SDI)
/LED_DO_3: D3.3 (SDO), D4.4 (SDI)
/LED_DO_4: D4.3 (SDO), D5.4 (SDI)
/LED_DO_5: D5.3 (SDO), D6.4 (SDI)
/LED_DO_6: D6.3 (SDO), D7.4 (SDI)
/LED_DO_7: D7.3 (SDO), D8.4 (SDI)
/LED_DO_8: D8.3 (SDO), D9.4 (SDI)
/LED_DO_9: D9.3 (SDO), D10.4 (SDI)
/LED_DO_10: D10.3 (SDO), D11.4 (SDI)
/LED_DO_11: D11.3 (SDO), D12.4 (SDI)
/LED_DO_12: D12.3 (SDO), D13.4 (SDI)
/LED_DO_13: D13.3 (SDO), D14.4 (SDI)
/LED_DO_14: D14.3 (SDO), D15.4 (SDI)
/LED_DO_15: D15.3 (SDO), D16.4 (SDI)
/LED_DO_16: D16.3 (SDO), D17.4 (SDI)
/LED_DO_17: D17.3 (SDO), D18.4 (SDI)
/LED_DO_18: D18.3 (SDO), D19.4 (SDI)
/LED_DO_19: D19.3 (SDO), D20.4 (SDI)
/LED_DO_20: D20.3 (SDO), D21.4 (SDI)
/LED_DO_21: D21.3 (SDO), D22.4 (SDI)
/LED_DO_22: D22.3 (SDO), D23.4 (SDI)
/LED_DO_23: D23.3 (SDO), D24.4 (SDI)
/LED_DO_24: D24.3 (SDO), D25.4 (SDI)
/LED_DO_25: D25.3 (SDO), D26.4 (SDI)
/LED_DO_26: D26.3 (SDO), D27.4 (SDI)
/LED_DO_27: D27.3 (SDO), D28.4 (SDI)
/LED_DO_28: D28.3 (SDO), D29.4 (SDI)
/LED_DO_29: D29.3 (SDO), D30.4 (SDI)
/LED_DO_30: D30.3 (SDO), D31.4 (SDI)
/LED_DO_31: D31.3 (SDO), D32.4 (SDI)
/LED_DO_32: D32.3 (SDO), D33.4 (SDI)
/LED_DO_33: D33.3 (SDO), D34.4 (SDI)
/LED_DO_34: D34.3 (SDO), D35.4 (SDI)
/LED_DO_35: D35.3 (SDO), D36.4 (SDI)
GND: C1.2, C2.2, C3.2, C4.2, C5.2, Cd1.2, Cd2.2, Cd3.2, Cd4.2, Cd5.2, Cd6.2, Cd7.2, Cd8.2, Cd9.2, D1.6 (GND), D2.6 (GND), D3.6 (GND), D4.6 (GND), D5.6 (GND), D6.6 (GND), D7.6 (GND), D8.6 (GND), D9.6 (GND), D10.6 (GND), D11.6 (GND), D12.6 (GND), D13.6 (GND), D14.6 (GND), D15.6 (GND), D16.6 (GND), D17.6 (GND), D18.6 (GND), D19.6 (GND), D20.6 (GND), D21.6 (GND), D22.6 (GND), D23.6 (GND), D24.6 (GND), D25.6 (GND), D26.6 (GND), D27.6 (GND), D28.6 (GND), D29.6 (GND), D30.6 (GND), D31.6 (GND), D32.6 (GND), D33.6 (GND), D34.6 (GND), D35.6 (GND), D36.6 (GND), D40.1 (A1), J1.2, J1.3, SW1.2, TP1.1, TP2.1, TP3.1, TP4.1, U1.1 (GND), U1.2 (GND), U1.11 (GND), U1.14 (GND), U1.36 (GND), U1.37 (GND), U1.38 (GND), U1.39 (GND), U1.40 (GND), U1.41 (GND), U1.42 (GND), U1.43 (GND), U1.44 (GND), U1.45 (GND), U1.46 (GND), U1.47 (GND), U1.48 (GND), U1.49 (GND), U1.50 (GND), U1.51 (GND), U1.52 (GND), U1.53 (GND), U2.2 (V_{SS}), U3.1, U3.4, U3.7 (GND), U4.3 (GND)

Notes on the sheet:
... 34 x APA102-2020 daisy-chain (balanced bar, both sides of hub) ...
POV Clock Minute Bar — minute (160mm balanced, 36x APA102)
Hall AH1806 index; 470uF+TVS on 5V; ESP-NOW frames only; SPI 8-12 MHz

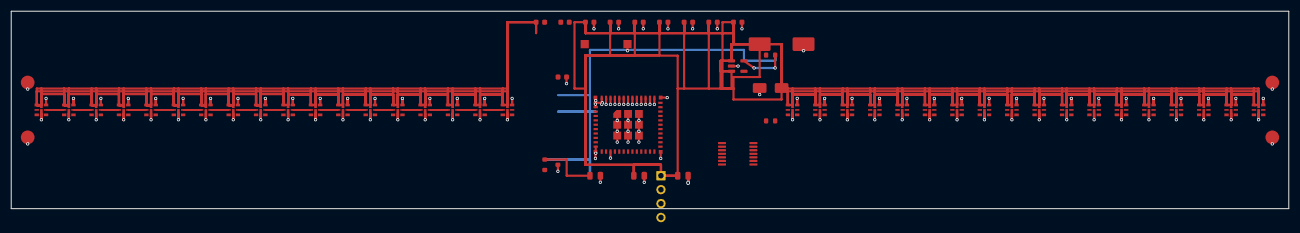
[picture p25: board hand-minute.kicad_pcb from above]

Board: 2 copper layers, 233.0 x 36.0 mm, 63 parts (0 on the bottom side), 80 nets.
