Jayweiii/Clockor/cad/build_assembly.py

#!/usr/bin/env python3
"""Hybrid Clockor mechanical assembly (CadQuery) — Chief Round 3 / v0.5.

Minute = spinning POV bar on solid shaft (Furitek 2204).
Hour = short stub axle in dial-center bearing, 1:1 belt/gear from off-axis
       28BYJ-48, entirely in front of bar sweep (no hollow tube).
AS5600 magnet on motor shaft REAR; SenRing G012 brush slip on FRONT (Mercotac alt).
Axial gap bar-tip plane → dial underside >= 5 mm including hub runout budget.
"""
from pathlib import Path
import math
import cadquery as cq
from cadquery import exporters

ROOT = Path(__file__).resolve().parents[1]
OUT = ROOT / "renders" / "mech"
CAD = ROOT / "cad"
OUT.mkdir(parents=True, exist_ok=True)
CAD.mkdir(parents=True, exist_ok=True)

# --- Key dims (mm) — ESTIMATE unless LOCKED ---
BASE_OD = 180.0
BASE_H = 22.0
PLATE_TH = 4.0
ENCL_H = 60.0
ENCL_TH = 2.5
MINUTE_LEN = 150.0
HOUR_LEN = 110.0
ARM_W = 10.0
ARM_TH = 1.6
HUB_R = 14.0
INNER_SHAFT_D = 5.0          # solid minute shaft ESTIMATE
HOUR_STUB_D = 3.0            # short stub axle at dial center (Round 3)
HOUR_STUB_LEN = 12.0
HOUR_BEARING_OD = 8.0        # small flange / thin-section at dial
HOUR_BEARING_ID = 3.0
HOUR_BEARING_H = 3.0
SHAFT_LEN = 90.0             # stops at hub / slip — does NOT pierce dial for hour
BEARING_OD = 16.0
BEARING_ID = 5.0
BEARING_H = 5.0
MOTOR_OD = 28.0              # Furitek KOMODO 2204
MOTOR_H = 19.0
STEPPER_OFFSET = 48.0        # off-axis 28BYJ-48 (drive plane in front of dial)
STEPPER_BODY = 28.0
PULLEY_OD = 16.0             # 1:1 matched pulleys
# SenRing G012 envelope ESTIMATE (through-bore brush capsule)
SLIP_OD = 35.0
SLIP_ID = 12.7
SLIP_H = 22.0
MAGNET_D = 6.0
MAGNET_H = 2.5
ENC_BOARD = 18.0
DIAL_ID = 10.0               # small hole for hour stub bearing only (minute shaft stays behind)
DIAL_OD = BASE_OD - 18.0
DIAL_TH = 2.0
MARKER_INNER = DIAL_OD / 2 - 14.0
MARKER_OUTER = DIAL_OD / 2 - 2.0
LED_SIZE = 2.0
LED_H = 0.9
N_LED_MIN = 36
AXIAL_GAP_BAR_TO_DIAL = 5.0  # mm LOCKED
HUB_RUNOUT_BUDGET = 1.0
HOUR_HOME_MAG_D = 2.0
HOUR_HOME_MAG_H = 1.0

# Z stations (rear negative → front positive)
Z_MAG = -MOTOR_H - 8.0
Z_ENC = Z_MAG - 4.0
Z_MOTOR = -MOTOR_H
Z_PLATE = 0.0
Z_BEARING1 = 6.0
Z_BEARING2 = 22.0
Z_SLIP = 28.0
Z_HUB = Z_SLIP + SLIP_H + 2.0
Z_BAR = Z_HUB
Z_DIAL = Z_BAR + ARM_TH + LED_H + AXIAL_GAP_BAR_TO_DIAL
Z_HOUR_BEARING = Z_DIAL
Z_HOUR_STUB = Z_DIAL - 1.0
Z_HOUR_PULLEY = Z_DIAL + DIAL_TH + 1.0
Z_HOUR_HAND = Z_HOUR_PULLEY + 7.0
Z_HOUR_STEPPER = Z_DIAL + DIAL_TH  # stepper body on dial front / bezel plane


def clock_to_cq(deg_cw_from_12: float) -> float:
    return deg_cw_from_12 - 90.0


MINUTE_CLOCK_DEG = 60.0
HOUR_CLOCK_DEG = 305.0
POV_MINUTE_DEG = 0.0
POV_HOUR_DEG = 180.0


def cyl(d, h, z0=0):
    return cq.Workplane("XY").workplane(offset=z0).circle(d / 2).extrude(h)


def tube(od, id_, h, z0=0):
    return (
        cq.Workplane("XY")
        .workplane(offset=z0)
        .circle(od / 2)
        .circle(id_ / 2)
        .extrude(h)
    )


def hand_blank(length, z, both_sides=False):
    hub = cyl(HUB_R * 2, ARM_TH, z)
    if both_sides:
        arm_r = (
            cq.Workplane("XY")
            .workplane(offset=z)
            .center(length / 2, 0)
            .rect(length, ARM_W)
            .extrude(ARM_TH)
        )
        arm_l = (
            cq.Workplane("XY")
            .workplane(offset=z)
            .center(-length / 2, 0)
            .rect(length, ARM_W)
            .extrude(ARM_TH)
        )
        return hub.union(arm_r).union(arm_l)
    arm = (
        cq.Workplane("XY")
        .workplane(offset=z)
        .center(length / 2, 0)
        .rect(length, ARM_W)
        .extrude(ARM_TH)
    )
    return hub.union(arm)


def led_row_balanced(length, n_led, z, clock_deg):
    n_side = n_led // 2
    start = HUB_R + 4.0
    usable = length - start - 4.0
    pitch = usable / max(n_side - 1, 1)
    ang = clock_to_cq(clock_deg)
    shape = None
    for side in (+1, -1):
        for i in range(n_side):
            r = side * (start + i * pitch)
            led = (
                cq.Workplane("XY")
                .workplane(offset=z + ARM_TH)
                .center(r, 0)
                .rect(LED_SIZE, LED_SIZE)
                .extrude(LED_H)
                .rotate((0, 0, 0), (0, 0, 1), ang)
            )
            shape = led if shape is None else shape.union(led)
    return shape


def minute_hand(length, z, clock_deg):
    blank = hand_blank(length, z, both_sides=True).rotate(
        (0, 0, 0), (0, 0, 1), clock_to_cq(clock_deg)
    )
    leds = led_row_balanced(length, N_LED_MIN, z, clock_deg)
    return blank.union(leds)


def hour_hand_only(length, z, clock_deg):
    blank = (
        cq.Workplane("XY")
        .workplane(offset=z)
        .moveTo(0, 0)
        .circle(5)
        .moveTo(length / 2, 0)
        .rect(length, 6)
        .extrude(1.2)
        .rotate((0, 0, 0), (0, 0, 1), clock_to_cq(clock_deg))
    )
    return blank


def dial_face(z):
    ring = tube(DIAL_OD, DIAL_ID, DIAL_TH, z)
    markers = None
    for h in range(12):
        ang = clock_to_cq(h * 30.0)
        major = h % 3 == 0
        w = 4.0 if major else 2.0
        thick = 1.2 if major else 0.8
        mid_r = (MARKER_INNER + MARKER_OUTER) / 2
        length = MARKER_OUTER - MARKER_INNER
        m = (
            cq.Workplane("XY")
            .workplane(offset=z + DIAL_TH)
            .center(mid_r, 0)
            .rect(length, w)
            .extrude(thick)
            .rotate((0, 0, 0), (0, 0, 1), ang)
        )
        markers = m if markers is None else markers.union(m)
    return ring.union(markers)


def bearing(z, od=BEARING_OD, id_=BEARING_ID, h=BEARING_H):
    return tube(od, id_, h, z)


def motor_on_axis(z):
    body = cyl(MOTOR_OD, MOTOR_H, z)
    rear = cyl(3.0, 6.0, z - 6.0)
    front = cyl(INNER_SHAFT_D, 8.0, z + MOTOR_H)
    return body.union(rear).union(front)


def stepper_off_axis(x, y, z):
    """Stepper body on dial-front plane (in front of bar sweep)."""
    body = (
        cq.Workplane("XY")
        .workplane(offset=z)
        .center(x, y)
        .circle(STEPPER_BODY / 2)
        .extrude(19)
    )
    shaft = (
        cq.Workplane("XY")
        .workplane(offset=z + 19)
        .center(x, y)
        .circle(2.5)
        .extrude(8)
    )
    return body.union(shaft)


def pulley(x, y, z, od=PULLEY_OD):
    return (
        cq.Workplane("XY")
        .workplane(offset=z)
        .center(x, y)
        .circle(od / 2)
        .extrude(6)
    )


def belt_approx(x1, y1, x2, y2, z, w=4):
    mx, my = (x1 + x2) / 2, (y1 + y2) / 2
    dx, dy = x2 - x1, y2 - y1
    L = math.hypot(dx, dy)
    ang = math.degrees(math.atan2(dy, dx))
    return (
        cq.Workplane("XY")
        .workplane(offset=z)
        .transformed(offset=(mx, my, 0), rotate=(0, 0, ang))
        .rect(L, w)
        .extrude(1.5)
    )


def build_common():
    base = cyl(BASE_OD, BASE_H, -BASE_H)
    plate = cyl(BASE_OD - 10, PLATE_TH, Z_PLATE)
    # solid minute shaft — rear magnet through slip/hub only (stops before dial)
    minute_shaft = cyl(INNER_SHAFT_D, Z_HUB + 8 - Z_MAG, Z_MAG)
    b1 = bearing(Z_BEARING1)
    b2 = bearing(Z_BEARING2)
    # SenRing G012-class brush through-bore on FRONT (collar on Ø5 shaft)
    slip_rotor = tube(SLIP_ID + 4, INNER_SHAFT_D + 0.3, SLIP_H - 4, Z_SLIP + 2)
    slip_stator = tube(SLIP_OD, SLIP_ID, SLIP_H, Z_SLIP)
    mag = cyl(MAGNET_D, MAGNET_H, Z_MAG)
    enc = (
        cq.Workplane("XY")
        .workplane(offset=Z_ENC)
        .center(0, 0)
        .rect(ENC_BOARD, ENC_BOARD)
        .extrude(1.2)
    )
    motor = motor_on_axis(Z_MOTOR)
    # --- Round 3 hour path: stub + dial bearing + 1:1 in front of bar ---
    hour_brg = bearing(Z_HOUR_BEARING, HOUR_BEARING_OD, HOUR_BEARING_ID, HOUR_BEARING_H)
    hour_stub = cyl(HOUR_STUB_D, HOUR_STUB_LEN, Z_HOUR_STUB)
    hour_home_mag = cyl(HOUR_HOME_MAG_D, HOUR_HOME_MAG_H, Z_HOUR_STUB + HOUR_STUB_LEN - 1)
    p_hour = pulley(0, 0, Z_HOUR_PULLEY, od=PULLEY_OD)
    step = stepper_off_axis(STEPPER_OFFSET, 0, Z_HOUR_STEPPER)
    p_step = pulley(STEPPER_OFFSET, 0, Z_HOUR_PULLEY)
    belt = belt_approx(STEPPER_OFFSET, 0, 0, 0, Z_HOUR_PULLEY + 2)
    encl = tube(BASE_OD - 4, BASE_OD - 4 - 2 * ENCL_TH, ENCL_H, PLATE_TH)
    dial = dial_face(Z_DIAL)
    gap_vis = tube(HUB_R * 2 + 8, HUB_R * 2 + 4, AXIAL_GAP_BAR_TO_DIAL, Z_BAR + ARM_TH + LED_H)
    return (
        base.union(plate)
        .union(minute_shaft)
        .union(b1)
        .union(b2)
        .union(slip_rotor)
        .union(slip_stator)
        .union(mag)
        .union(enc)
        .union(motor)
        .union(hour_brg)
        .union(hour_stub)
        .union(hour_home_mag)
        .union(p_hour)
        .union(step)
        .union(p_step)
        .union(belt)
        .union(encl)
        .union(dial)
        .union(gap_vis)
    )


def build_pose(minute_deg, hour_deg):
    common = build_common()
    m = minute_hand(MINUTE_LEN, Z_BAR, minute_deg)
    h = hour_hand_only(HOUR_LEN, Z_HOUR_HAND, hour_deg)
    return common.union(m).union(h)


assy_clock = build_pose(MINUTE_CLOCK_DEG, HOUR_CLOCK_DEG)
assy_pov = build_pose(POV_MINUTE_DEG, POV_HOUR_DEG)
assy = assy_clock

exploded = (
    cyl(BASE_OD, BASE_H, -BASE_H)
    .union(cyl(BASE_OD - 10, PLATE_TH, 0))
    .union(dial_face(Z_DIAL).translate((0, 0, 20)))
    .union(minute_hand(MINUTE_LEN, Z_BAR, MINUTE_CLOCK_DEG).translate((0, 0, 35)))
    .union(hour_hand_only(HOUR_LEN, Z_HOUR_HAND, HOUR_CLOCK_DEG).translate((0, 0, 50)))
    .union(motor_on_axis(Z_MOTOR).translate((0, 0, -15)))
    .union(stepper_off_axis(STEPPER_OFFSET, 0, Z_HOUR_STEPPER).translate((30, 0, 15)))
    .union(tube(SLIP_OD, SLIP_ID, SLIP_H, Z_SLIP).translate((45, 0, 0)))
    .union(cyl(HOUR_STUB_D, HOUR_STUB_LEN, Z_HOUR_STUB).translate((0, 0, 40)))
    .union(cyl(MAGNET_D, MAGNET_H, Z_MAG).translate((0, 0, -25)))
)

half = cq.Workplane("XY").box(
    BASE_OD * 1.2, BASE_OD * 1.2, 240, centered=(True, False, True)
)
section = assy.intersect(half.translate((0, -BASE_OD * 0.6, 30)))

exporters.export(assy, str(CAD / "pov_clock_assembly.step"))
exporters.export(assy, str(CAD / "pov_clock_assembly.stl"))
exporters.export(assy_clock, str(CAD / "pov_clock_clock_mode.stl"))
exporters.export(assy_pov, str(CAD / "pov_clock_pov_mode.stl"))
exporters.export(exploded, str(CAD / "pov_clock_exploded.stl"))
exporters.export(section, str(CAD / "pov_clock_section.stl"))

(CAD / "STACK_UP_NOTES.txt").write_text(
    f"""Clockor hybrid CAD v0.5 (Round 3)
Z_MAG={Z_MAG} AS5600 magnet rear
Z_MOTOR={Z_MOTOR} Furitek 2204
Z_SLIP={Z_SLIP} SenRing G012 brush front (Mercotac 205 alt)
Z_BAR={Z_BAR} POV bar
Z_DIAL={Z_DIAL} clear acrylic (gap from bar top = {AXIAL_GAP_BAR_TO_DIAL} mm LOCKED incl. {HUB_RUNOUT_BUDGET} mm runout budget)
Z_HOUR_STUB={Z_HOUR_STUB} short stub axle @ dial center bearing OD={HOUR_BEARING_OD}
Z_HOUR_HAND={Z_HOUR_HAND} hour hand in front of dial
Hour drive: 1:1 belt @ Z_HOUR_PULLEY={Z_HOUR_PULLEY} from stepper @ x={STEPPER_OFFSET} — entirely in front of bar sweep
NO hollow hour tube around minute shaft
See docs/stack-up.md
"""
)

opts = {
    "width": 900,
    "height": 700,
    "marginLeft": 40,
    "marginTop": 40,
    "showAxes": False,
    "strokeWidth": 0.35,
}


def export_svg(shape, name, projectionDir=(1, 1, 1)):
    exporters.export(
        shape,
        str(OUT / name),
        exportType=exporters.ExportTypes.SVG,
        opt={
            **opts,
            "projectionDir": projectionDir,
            "strokeColor": (30, 30, 40),
            "hiddenColor": (180, 180, 190),
            "showHidden": False,
        },
    )


export_svg(assy_clock, "iso.svg", (1.2, -1.5, 1.0))
export_svg(assy_clock, "clock_iso.svg", (1.2, -1.5, 1.0))
export_svg(assy_clock, "clock_front.svg", (0, 0, 1))
export_svg(assy_pov, "pov_iso.svg", (1.2, -1.5, 1.0))
export_svg(assy_pov, "pov_front.svg", (0, 0, 1))
export_svg(exploded, "exploded.svg", (1.2, -1.5, 1.0))
export_svg(section, "section.svg", (0.2, -1.0, 0.15))
export_svg(assy_clock, "front.svg", (0, -1, 0))
print("CAD v0.5 OK — hybrid Round 3 stub-axle hour + SenRing slip")
print(f"LOCKED axial gap bar→dial = {AXIAL_GAP_BAR_TO_DIAL} mm (Z_DIAL={Z_DIAL}, Z_BAR={Z_BAR})")
print(f"Hour 1:1 drive plane Z={Z_HOUR_PULLEY} (in front of bar Z={Z_BAR})")
for p in sorted(CAD.glob("pov_*")) + sorted(CAD.glob("STACK*")):
    print(p.name, p.stat().st_size)
