Jayweiii/Clockor/(commit log)

2026-11-01 Initial clockor KiCad 9 package: ERC-clean schematics
    Three boards (base-controller, hand-minute, hand-hour) with official
    KiCad + Espressif symbols, custom Clockor DRV8313, 0 ERC errors.
    PCBs placed from netlist (unrouted — Freerouting native CLI crashes).
    KiBot workflow (ERC gate), review ERC/DRC reports + sch PDFs + PCB SVGs.
    [base-controller.kicad_pcb, base-controller.kicad_sch, hand-hour.kicad_pcb, hand-hour.kicad_sch, hand-minute.kicad_pcb, hand-minute.kicad_sch, pov_clock_assembly.step, pov_clock_assembly.stl]
2026-11-01 Fix KiBot CI paths and portable lib tables
    - Workflow: schema/board are full repo paths; dir is kibot_out only
    - sym/fp-lib-table use ${KIPRJMOD}/../libs/... for Actions + local
    [rebuild_boards.py]
2026-11-01 Fix base-controller KiBot ERC: valid refs + +5V PWR_FLAG
    Rename R_EN/R_M*F/C_M*_* to R20–R22/C20–C25 (KiBot requires PREFIX+digits).
    Add #FLG06 on +5V for KiBot’s power_pin_not_driven check.
    [base-controller.kicad_pcb, base-controller.kicad_sch]
2026-11-01 Refresh pcb-status docs and review DRC/ERC reports
2026-11-01 Hybrid v0.3: spinning minute POV bar + stepper hour
    Jason chose hybrid after Chief Round 1. Drop hand-hour rotor board and
    TCA9548A; drive minute with one DRV8313 + 2204-class BLDC and hour with
    ULN2003A + 28BYJ-48. Minute bar adds AH1806 hall index, 470uF bulk, SMAJ5.0A
    TVS, and balance pads. Docs: architecture, review changelog, LCSC, BOMs.
    ERC 0 errors on base-controller and hand-minute; CI matrix is two boards.
    [base-controller.kicad_pcb, base-controller.kicad_sch, base_controller_bom.csv, hand-hour.kicad_pcb, hand-hour.kicad_sch, hand-minute.kicad_pcb, hand-minute.kicad_sch, hand_minute_bom.csv]
2026-11-01 Hybrid v0.4 Chief Round 2: lock motor/slip, stack-up, firmware docs
    - Dial clear acrylic; hour stepper off-axis + hollow shaft; >=5 mm bar-to-dial gap
    - Lock Furitek KOMODO 2204 1400KV 12S14P; Mercotac 205 (4 A, 2000 RPM datasheet)
    - AS5600 magnet shaft rear; Mercotac front; CAD + docs/stack-up.md
    - Firmware interlocks: soft-start, hall/ESP-NOW spin-down, ~1.2 A LED cap;
    hour half-step + coil de-energize (docs/firmware-interlocks.md)
    - DSN export OK; Freerouting CLI crashes; simple_route experimental only;
    CI run_drc remains false (no 0-error route yet)
    - Fix J8/J7 placement inside board outline
    [base-controller.kicad_pcb, hand-minute.kicad_pcb, master_bom_aggregated.csv, pov_clock_assembly.step, pov_clock_assembly.stl, pov_clock_clock_mode.stl, pov_clock_exploded.stl, pov_clock_pov_mode.stl]
2026-11-01 Hybrid v0.5 Chief Round 3: stub hour 1:1, hour home, SenRing primary, short-free PCBs
    - Hour: dial-center stub axle + bearing, 1:1 belt/gear from off-axis 28BYJ-48,
    entirely in front of bar sweep (docs/stack-up + CAD); no hollow tube.
    - Base sch: AH1806 hour-home (U6/J9 /HR_HOME); drive ratio locked 1:1.
    - Slip: SenRing G012 brush primary (linked catalog PDF); Mercotac 205 alt
    with orientation + mercury disposal notes.
    - Boards: pad-aware careful_route → 0 shorting_items both; ERC 0 errors.
    Full 0 DRC not reached (unconnected/silk/courtyard); KiBot run_drc stays false.
    [base-controller.kicad_pcb, base-controller.kicad_sch, hand-minute.kicad_pcb, hand-minute.kicad_sch, pov_clock_assembly.step, pov_clock_assembly.stl, pov_clock_clock_mode.stl, pov_clock_exploded.stl]
2026-11-01 Round 3+: 0 non-UC DRC errors, enable KiBot DRC, PCB renders
    Both boards stay short-free with zero non-unconnected DRC errors after
    NPTH/clearance/dangling hygiene. Unconnected nets remain (~68 base, ~74
    hand); CI enables run_drc with ignore_unconnected. Fresh copper + 3D
    renders under renders/ for the review deck.
    [base-controller.kicad_pcb, base-controller.step, hand-minute.kicad_pcb, hand-minute.step]
2026-11-02 Give Claude KiCad 9 + wire base-board KiBot config
    - Run Claude job in ghcr.io/inti-cmnb/kicad9_auto_full (same family as
    INTI-CMNB/KiBot@v2_k9) and install Node/gh so JS actions work.
    - Allow kicad-cli, kibot, python3, pip, git, and gh pr tools.
    - KiBot CI: base-controller uses kibot.base.yml when present (strict
    unconnected), else kibot.yml; hand-minute stays on kibot.yml.
2026-11-02 Raise Claude job timeout to 120m for base-board routing
    The prior @claude routing pass hit the 60m cancel with ~9 unconnected
    left and no PR. Give the next pass enough headroom to finish DRC + PR.
2026-11-02 Add base-board grid router script (WIP, not yet run)
2026-11-02 route_base: hit-test pad cells, keepouts, hole spacing, stub fixes, net priority
    [route_base.py]
2026-11-02 Base board: partial routing pass (WIP) + strict kibot.base.yml
    [base-controller.kicad_pcb]
2026-11-02 Base board: route power/signals (68 -> 5 unconnected, 0 clearance errors); renders + status
    Partial: M1_CPH, M1_OUTC, USB_D+ still unconnected; +5V and motor phases
    narrower than the approved rule. See docs/pcb-status.md.
    [base-controller.kicad_pcb]
2026-11-03 route_base: via-in-stub escape for USB_D+ on J2; add GND cluster/island analysis helpers
2026-11-03 route_base: GND cluster linking with rip-up, dead stitching via pruning
2026-11-03 Base board: close M1_CPH, M1_OUTC, USB_D+ (5 -> 2 unconnected, 0 DRC violations); renders + status
    [base-controller.kicad_pcb]
2026-11-04 Base board: join the 2 isolated GND clusters to the main pour (unconnected 2 -> 0, 0 DRC violations)
    Ripped M1_IN1 in the U5 comb, ran GND links out of both pockets, re-routed
    M1_IN1 around them and re-routed a local window of M1_EN1. Only M1_IN1,
    M1_EN1 and GND copper changed; widths untouched. scripts/gnd_fix.py does the
    surgery; gnd_probe/netinfo/diff_copper are helpers.
    [base-controller.kicad_pcb]
2026-11-04 scripts: widths.py (per-net min width / length under 1.5 mm) and inflate.py (greedy in-place widening with DRC shrink loop)
2026-11-05 scripts: gen_reroute_net.py / reroute_net.py (re-route only a chosen set of nets, everything else fixed)
    [gen_reroute_net.py]
2026-11-05 Base board: +5V rerouted as 1.5 mm trunk (necks 15.1 mm), VIN_12V/BUCK_SW/USB_D+-/M1_IN1/M1_EN1 re-laid; DRC 0 violations, 0 unconnected
    [base-controller.kicad_pcb]
